2025kuhshw-design/Chess_RobotArm/docs/layout_diagram.png

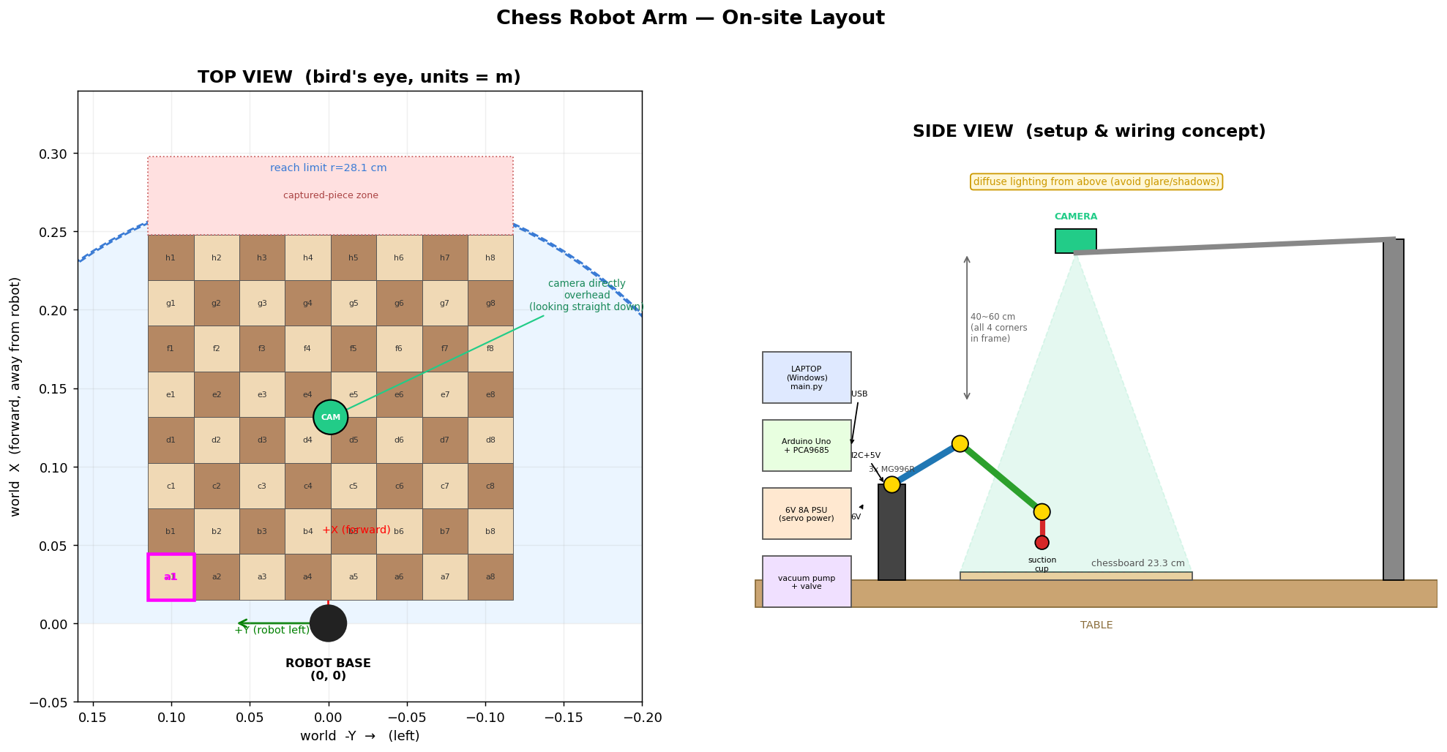
docs/layout_diagram.png
