2025kuhshw-design/Chess_RobotArm/docs/TROUBLESHOOTING_LOG.md

# 문제 해결 기록

체스 두는 로봇팔을 만들면서 실제로 막혔던 지점과 해결 방법.
**설계 단계에는 없었고, 실물을 만든 뒤에야 드러난 문제가 대부분이다.**

---

## 이 시스템이 어떻게 동작하는지 (처음 보는 사람용)

```
[카메라] 체스판을 위에서 내려다봄
   ↓  사람이 둔 수를 알아냄 (이전 사진과 지금 사진을 비교)
[체스 엔진] 다음 수를 계산
   ↓  "e7의 기물을 e5로 옮겨라"
[역기구학] 그 칸의 위치를 관절 각도로 변환
   ↓  "1번 63도, 2번 45도, 3번 160도"
[아두이노 → 서보모터] 팔을 움직이고 흡착기로 기물을 집어 옮김
```

이 네 단계 중 **어느 하나라도 어긋나면 로봇은 엉뚱한 곳을 짚는다.**
아래 문제들은 대부분 "각 단계는 맞는데 단계 사이의 약속이 틀어진" 경우다.

---

## 우선순위 한눈에 보기

`★★★` 이걸 못 고치면 프로젝트가 아예 성립 안 됨
`★★` 동작은 하지만 실패율이 높거나 부품이 망가짐
`★` 불편하지만 우회 가능

| 우선순위 | 문제 | 분야 |
|:---:|---|:---:|
| ★★★ | 어깨 높이가 코드에 없어 팔이 체스판에 닿지 못함 | SW |
| ★★★ | 팔꿈치 꺾이는 방향이 코드와 반대 | SW |
| ★★★ | 가로·세로 축이 뒤바뀌어 사람의 수를 전부 "반칙"으로 판정 | SW |
| ★★★ | 좌표가 거울처럼 뒤집혀 정반대 칸을 짚음 | SW |
| ★★★ | 흡착기가 아예 작동하지 않음 (제어 방식이 다름) | HW+SW |
| ★★★ | 펌프 전류가 모터 드라이버를 태움 | HW |
| ★★★ | 서보모터가 갑자기 튀어 기어가 파손됨 | HW+SW |
| ★★★ | 기물 32개를 전부 '빈 칸'으로 읽어 사람의 수를 감지 못함 | SW |
| ★★★ | 검은 기물이 어두운 칸에서만 안 보임 (밝기로는 구분 불가) | SW |
| ★★★ | 카메라 보정 결과를 하강 직전에 버려서 보정이 사실상 무효 | SW |
| ★★★ | 높은 데서 정렬해 시차로 한 칸 어긋남 (내려가면 틀어짐) | SW |
| ★★★ | 캐슬링·앙파상에서 엔진과 실제 판이 어긋남 | SW |
| ★★ | 기물을 집자마자 그 자리에 도로 떨어뜨림 | SW |
| ★★ | 흡착기가 기물에 안 붙음 (덜 내려감) | SW+HW |
| ★★ | 캘리브레이션 격자가 어긋나 칸이 밀림 | 사용법 |
| ★★ | 게임 도중 "도달 불가" 오류로 강제 종료 | SW |
| ★★ | 1번 관절 결합부 유격 → 위치가 매번 달라짐, 결국 서보 고장·교체 | HW |
| ★★ | 서보 교체 후 정면 기준각이 38°→85°로 바뀜 | HW+SW |
| ★★ | 칸 하나만 잘못 읽혀도 이동 감지 실패 / 잡는 수는 감지 불가 | SW |
| ★★ | 정확도를 올리려던 강화학습이 실제로는 효과 없음 | SW |
| ★ | 팔이 흔들려(3~4Hz) 집기 정확도 저하 | HW+SW |
| ★ | 로봇팔이 카메라를 가려 기물 인식이 깨짐 | SW |
| ★ | 마커(스티커) 색을 체스판으로 오인식 | SW |
| ★ | 개발 환경 설치 실패 (파이썬 버전, 라이브러리 등) | 환경 |

---

# ★★★ 치명적 — 못 고치면 프로젝트가 성립 안 됨

## 1. 어깨 높이가 코드에 없었다 (SW)

**무슨 일이 있었나**
로봇팔을 조립하고 "e5 칸으로 가"라고 시켰는데, **팔이 체스판 근처에도 못 갔다.**
어느 칸을 시켜도 "서보 각도가 범위를 벗어났다"는 오류만 났다.

**왜 그랬나**
로봇팔의 어깨 관절은 체스판보다 **8.9cm 위**에 있다. 그런데 코드는 어깨가
**체스판과 같은 높이**에 있다고 계산하고 있었다. 8.9cm 차이를 모른 채
"팔을 얼마나 굽혀야 하나"를 계산하니 답이 나올 리가 없었다.

> 비유하자면, 책상 위 물건을 집으려는데 자기 어깨가 책상 위에 있다고 착각한 것.

**어떻게 고쳤나**
`SHOULDER_HEIGHT` 값을 새로 만들어 8.9cm를 넣었다. 그러자 정상 동작.

---

## 2. 팔꿈치가 반대로 꺾인다 (SW)

**무슨 일이 있었나**
위와 같은 증상. 어깨 높이를 고쳐도 여전히 범위를 벗어났다.

**왜 그랬나**
팔이 특정 지점에 닿는 방법은 **두 가지**다 — 팔꿈치를 위로 꺾거나, 아래로 꺾거나.
(사람이 물건을 집을 때 팔꿈치를 들 수도, 내릴 수도 있는 것과 같다.)
코드는 **한 가지 방법만** 계산하고 있었는데, 우리 로봇팔은 그 반대 방향으로만
꺾이는 구조였다.

**어떻게 고쳤나**
`ELBOW_SIGN`이라는 선택 스위치를 만들어 "아래로 꺾기"를 선택했다.

> 이 두 문제(1·2)를 고치기 전까지 **로봇팔은 체스판에 닿을 수조차 없었다.**
> 코드로는 몇 줄이지만, 이게 없으면 아무리 잘 만든 AI도 소용없다.

---

## 3. 가로·세로가 뒤바뀌어 사람의 수를 전부 "반칙"으로 판정 (SW)

**무슨 일이 있었나**
사람이 정상적으로 폰을 두 칸 전진시켰는데, 프로그램이 **"불법 이동입니다"**
라며 거부했다. 어떤 수를 둬도 마찬가지였다.

**왜 그랬나**
체스판에는 두 방향이 있다.
- **랭크**(1~8): 사람 쪽에서 상대 쪽으로 가는 방향
- **파일**(a~h): 좌우 방향

코드가 이 둘을 **뒤바꿔** 놓고 있었다. 그래서 사람 앞의 두 줄이 "1·2랭크"가
아니라 "g·h파일"로 인식됐다. 체스 규칙상 백 기물은 1·2랭크에서 시작해야 하는데
엉뚱한 곳에 있으니, 엔진이 모든 수를 반칙으로 본 것이다.

**어떻게 고쳤나**
랭크가 로봇↔사람 방향이 되도록 좌표 계산식을 바로잡았다.

---

## 4. 좌표가 거울처럼 뒤집혀 있었다 (SW)

**무슨 일이 있었나**
"오른쪽 칸으로 가"라고 하면 왼쪽으로 갔다.

**왜 그랬나**
카메라가 보는 좌표를 로봇 좌표로 바꾸는 계산이 **거울상**이었다.
방향만 맞추면 될 것 같지만, 거울상은 아무리 돌려도 원래대로 안 된다.
(왼손과 오른손은 아무리 돌려도 겹쳐지지 않는 것과 같다.)

**어떻게 고쳤나**
네 가지 배치(로봇이 위/아래/왼쪽/오른쪽)를 전부 다시 계산해서,
모두 거울상이 아닌 올바른 회전이 되도록 검증했다.

---

## 5. 흡착기가 아예 작동하지 않았다 (HW+SW)

**무슨 일이 있었나**
"흡착 켜"를 아무리 보내도 펌프가 안 돌았다. 배선도 맞고 전원도 들어와 있었다.

**왜 그랬나**
펌프를 켜고 끄는 부품(스위치 모듈)이 예상과 **다른 방식**이었다.
- 예상: 전기를 계속 보내면 켜짐
- 실제: **서보모터에 보내는 것 같은 신호(짧은 펄스)**를 보내야 켜짐

**어떻게 고쳤나**
아두이노가 서보 펄스 형태로 신호를 보내도록 바꿨다.
(부품 사진을 보고 입력선이 서보와 같은 3선인 걸 확인하고서야 알았다.)

---

## 6. 펌프 전류가 모터 드라이버를 태웠다 (HW)

**무슨 일이 있었나**
흡착기를 켜자 **서보모터와 흡착기가 동시에 전부 힘이 빠졌다.** 결국 모터
드라이버가 고장 나서 교체해야 했다.

**왜 그랬나**
펌프는 켜지는 순간 **순간적으로 매우 큰 전류**(수 암페어)를 끌어당긴다.
그 전류가 **모터 드라이버 보드를 통과**하도록 배선돼 있었는데, 그 보드의
전원 배선은 서보모터용으로 가늘게 설계돼 있어 감당하지 못했다.

> 굵은 수도관(전원)이 있어도 중간에 빨대(드라이버 배선)를 끼우면 물이 안 나온다.

**어떻게 고쳤나**
펌프의 전원선을 **드라이버를 거치지 않고 외부 전원에 직접** 연결했다.
드라이버에는 "켜라/꺼라" 신호선만 남겼다.

---

## 7. 서보모터가 갑자기 튀어 기어가 파손됐다 (HW+SW)

**무슨 일이 있었나**
각도를 크게 바꾸는 명령을 넣자 **칠판 긁는 소리**가 났고, 열어보니 서보 내부
플라스틱 기어가 갈려 있었다.

**왜 그랬나**
서보모터는 목표 각도를 받으면 **자기 최대 속도로** 그리로 간다. 90도를 한 번에
움직이면 팔이 세게 휘둘러지고, 멈출 때 큰 충격이 걸린다. 게다가 팔이 구조물에
걸려 못 움직이는데도 계속 힘을 주면 기어가 갈린다.

**어떻게 고쳤나**
목표까지 **2도씩 나눠서** 여러 번 보내도록 바꿨다. (한 번에 "90도로 가"가 아니라
"2도, 4도, 6도…" 하고 순차적으로 보냄) 이러면 천천히 부드럽게 움직인다.

**추가 문제**: 전원을 켠 직후에는 팔이 어디 있는지 코드가 알 수 없어(위치 센서가
없음) 나눠 보낼 수가 없었다. → **기동 절차**를 만들어, 사람이 팔을 잡고
"지금 여기 있다"고 알려준 뒤 시작하도록 했다.

---

# ★★ 중요 — 동작은 하지만 실패하거나 망가짐

## 8. 기물을 집자마자 도로 떨어뜨렸다 (SW)

**증상**: 흡착기가 기물을 붙잡았는데, 팔을 들어올리는 순간 놓아버림.

**원인**: 팔을 움직이는 함수가 **흡착 상태를 넘겨받지 않아서**, 움직일 때마다
"흡착 꺼짐"으로 덮어쓰고 있었다.

**해결**: 집은 뒤 놓을 때까지 모든 이동 구간에 "흡착 유지"를 명시적으로 전달.
놓는 지점을 코드상 **한 곳으로만** 정리했다.

---

## 9. 흡착기가 기물에 안 붙었다 (SW+HW)

**증상**: 정확한 위치까지 내려가는데도 진공이 안 걸림.

**원인**: 흡착컵은 고무라서 **살짝 눌러야** 밀착돼 진공이 생긴다. 그런데 코드는
기물 윗면 **정확히**까지만 내려가도록 되어 있어 눌리지 않았다.

**해결**: 기물 윗면보다 **4mm 더** 내려가도록 설정(`TOUCH_PRESS`).
현장에서 `zoff 8` 같은 명령으로 실시간 조정할 수 있게 했다.

---

## 10. 캘리브레이션 격자가 어긋났다 (사용법)

**증상**: 카메라가 만든 8×8 격자가 실제 체스판 칸과 조금씩 밀려 있음.

**원인**: 카메라 설정 시 네 모서리를 찍어야 하는데, **모서리 칸의 중앙**을 찍었다.
중앙끼리의 거리는 **7칸**인데 코드는 그 범위를 **8칸**으로 나누니 전체가 밀린다.

**해결**: 8×8 영역의 **바깥 꼭짓점**을 찍도록 안내. 보드 테두리가 둥글어 찍기
어려운 경우를 위해, 중앙을 찍으면 자동으로 환산해주는 모드도 추가했다.

---

## 11. 게임 도중 "도달 불가" 오류로 강제 종료 (SW)

**두 가지 원인이 있었다.**

**(a) 들어올리는 높이가 고정이었다**
먼 칸에서는 8cm를 들어올리면 팔 길이를 초과한다.
→ 칸마다 가능한 최대 높이를 계산하도록 변경.

**(b) 잡은 기물을 놓는 위치가 팔 밖이었다**
"잡은 칸에서 옆으로 5cm" 지점에 놓게 되어 있었는데, 구석 칸에서는 그 지점이
팔이 닿는 범위 밖(30.1cm > 29.5cm)이었다.
→ 보드 바깥의 **고정된 자리**(팔이 확실히 닿는 곳)에 순서대로 놓도록 변경.

---

## 12. 1번 관절 결합부 유격 (HW) — **아직 미해결**

**증상**: 같은 명령을 줘도 **매번 조금씩 다른 위치**에 도달한다.

**원인**: 베이스 관절 결합부가 헐거워 팔이 흔들린다. 팔이 길어서 결합부의
작은 유격이 끝단에서 크게 증폭된다.

**왜 중요한가**: 유격이 있으면 **미리 계산해둔 보정값이 소용없다.** 오차가 매번
달라지기 때문이다. → 그래서 아래 13번의 접근 방식 변경이 필요했다.

**해결**: 기계적으로 조여야 한다. 소프트웨어로는 못 고친다.

**후속**: 결국 이 서보가 완전히 고장나 **회전 자체를 하지 않게 됐다.**
교체한 새 서보는 혼(horn) 결합 위치가 달라 **정면이 85°** 다(이전 서보는 38°).
`SERVO1_HOME`과 `PARK_POSE`를 그에 맞춰 고쳤다. → 아래 12-B 참고.

---

## 12-B. 베이스 서보 교체 후 정면 기준각이 바뀜 (HW+SW)

**증상**: 1번(베이스) 모터가 명령을 줘도 전혀 돌지 않음 → 서보 자체 고장.
교체 후에는 팔이 엉뚱한 방향을 향함.

**원인**: 서보에는 위치 센서가 없고, 팔(혼)을 어느 각도에 끼우느냐에 따라
"몇 도가 정면인가"가 달라진다. 교체하면 이 기준각이 바뀐다.
이전 서보는 38°가 정면, 새 서보는 실측 결과 **85°가 정면**.

**해결**: 소프트웨어에서 기준각만 바꾼다. 기구를 다시 분해할 필요는 없다.
(`a` 명령으로 몇 도일 때 정면을 향하는지 직접 재서 확인 — 아래 절차 참고.)

```python
# hardware/arm_controller.py
SERVO1_HOME = 85            # 38 → 85 (실측)
PARK_POSE   = (85, 140, 180)
```

**부수 효과(좋은 쪽)**: 예전에는 정면이 38°라 **오른쪽 회전 여유가 38°뿐**이었다.
이제 정면이 85°라 좌우 여유가 거의 같다. 실제 사용 범위는 s1 ≈ 65~137°로,
양쪽 끝(0°/180°)에서 충분히 떨어져 있다.

**교훈**: 모터를 교체하면 코드의 기준각도 반드시 다시 재야 한다.
기준각은 "모터의 성질"이 아니라 "모터와 팔을 어떻게 결합했는가"의 값이다.

---

## 12-C. 기물을 하나도 인식하지 못했다 (SW)

**증상**: 시작 배치를 놓고 실행했는데 카메라가 **32개 기물을 전부 빈 칸**으로
읽었다. 그래서 기물을 옮겨도 "이동 감지 실패"만 반복됐다.

**원인**: 기물이 있는지를 **셀 중앙의 밝기 분산**으로 판정하고 있었다.
"기물이 있으면 무늬가 생겨 분산이 커진다"는 발상이었는데, 정반대였다.
기물이 셀 중앙을 덮으면 그 부분은 오히려 **한 가지 색으로 균일**해져
분산이 0에 가까워진다.

```
빈 밝은 칸          분산 5.6     ← 나뭇결 때문에 오히려 분산이 있다
흰 기물이 덮은 칸   분산 0.0     ← 균일해서 분산이 없다
검은 기물이 덮은 칸 분산 0.0
                    임계값 200 → 셋 다 "빈 칸"으로 판정
```

**해결**: 분산이 아니라 **밝기**로 판단한다.
"이 칸이 비었을 때의 밝기"와 비교해서 밝으면 흰 기물, 어두우면 검은 기물,
비슷하면 빈 칸. 기준 밝기는 *지금 비어 있어야 할 칸들*에서 매번 새로
계산하므로 조명이 변해도 따라간다.

**교훈**: 직관("기물이 있으면 복잡해 보이겠지")을 숫자로 확인하지 않았다.
분산 값을 한 번만 찍어봤다면 바로 알 수 있었다. 그래서 지금은
`vision/check_board.py` 가 칸별 숫자를 표로 보여준다.

---

## 12-C-2. 검은 기물이 어두운 칸에서만 안 보였다 (SW)

**증상**: 밝기 방식으로 고친 뒤에도 판독이 이랬다.

```
  8 b X b X b X b X      ← 한 칸 걸러 하나씩 안 잡힘
  7 X b X b X b X b
  2 X w w w w w w w
  1 w w w w w w w X
```

칸을 격자 좌표로 바꿔 보니 **놓친 칸이 전부 같은 색(어두운 칸)** 이었다.
흰 기물은 양쪽 칸에서 다 잡혔다.

**원인**: 당연한 얘기였다. **검은 기물과 어두운 칸은 둘 다 어둡다.**
밝기 하나로는 구분할 수가 없다. 임계값을 낮추면 검은 기물이 잡히기
시작하지만, 동시에 **빈 칸의 그림자도 기물로 잡힌다**(실제로 c3에 없는
기물이 나타났다). 맞바꿈이라 임계값 조정으로는 절대 해결되지 않는다.

**해결**: 기준을 "밝기"에서 **"빈 판과 얼마나 달라졌는가"** 로 바꿨다.
기물을 다 치운 판을 한 번 찍어두고, 매번 그것과 **픽셀 단위로 비교**한다.

- 검은 기물이 어두운 칸에 있어도 나뭇결·테두리·그림자가 달라지므로 잡힌다
- 나뭇결·얼룩은 빼기에서 상쇄되므로 잡음 문턱이 훨씬 낮아진다
  (밝기 방식 18 → 픽셀 방식 12)
- **평균이 아니라 '달라진 픽셀의 비율'** 로 판단하므로 기물이 작아도 된다
- 전체 조명 변화는 빈 칸들의 중앙값으로 보정한다

합성 영상 검증 (검은 기물 밝기를 어두운 칸과 **완전히 같게** 둔 최악의 경우):

| 상황 | 밝기 방식 | 빈 판 기준 |
|---|---|---|
| 시작 배치 | 48/64 | **64/64** |
| 빈 판 (오검출) | — | **64/64** |
| 조명 +20 | — | **64/64** |
| 조명 −30 | — | **64/64** |

**교훈**: 두 대상이 같은 값을 갖는다면, 그 값으로는 영원히 구분할 수 없다.
임계값을 계속 만지는 대신 **다른 측정량**을 찾아야 했다.

---

## 12-E-2. 정렬은 맞았다는데 내려가면 한 칸 어긋났다 (SW)

**증상**: 칸 위에서 정렬이 "완료"라고 뜨고 화면상으로도 맞아 보이는데,
하강하는 순간 한 칸 가까이 어긋났다. 흡착컵이 실제로는 e7 바로 위에 있는데
카메라 화면에는 마커가 e8 에 찍히기도 했다.

**원인**: **시차(parallax)**. 카메라가 판을 정확히 수직으로 내려다보지
않으면, 판 **위로 떠 있는** 마커는 판 평면에 투영될 때 밀려 보인다.
그리고 이 밀림은 **높이에 비례**한다.

```
밀림 = h/(H-h) x (판 중심에서의 거리)      h=마커 높이, H=카메라 높이
```

정렬은 안전높이(4.5cm)에서 했는데 실제 작업은 바닥(0.15cm)에서 한다.
높이가 다르니 밀림도 다르다. 즉 **높은 데서 "맞다"고 판단한 위치가
낮은 데서는 틀린 위치**였다.

| 정렬 높이 | 흡착컵 실제 오차 |
|---|---|
| 4.5cm (예전) | 19.0mm = 0.65칸 |
| 1.65cm | 6.5mm |
| **0.65cm (지금)** | **2.5mm** |

**해결**: **실제로 일할 높이에서 잰다.**

1. 기물 윗면 2mm 위까지 내려가서 측정
2. 보정이 필요하면 12mm 로 잠깐 올라가 옆으로 옮기고 다시 내려와 재측정
   (측정 높이에서 바로 옆으로 가면 옆 칸 기물을 밀어버린다)
3. 허용치 안에 들면 **그 자리에서 순수 수직으로만** 하강

핵심은 3번이다. 마지막 하강이 수직이면 그 사이 마커가 어떻게 보이든
**흡착컵의 실제 xy 는 변하지 않는다.** 그래서 남는 오차는 '정렬한 높이에서의
시차' 그 자체이고, 그 높이를 낮춘 만큼 그대로 줄어든다(4.5cm→0.65cm = 8배).

**교훈**: 센서를 **쓸 조건과 같은 조건에서** 재야 한다. 편한 높이에서 재고
다른 높이에서 쓰면, 측정이 아무리 정확해도 그 차이만큼 그대로 틀린다.

---

## 12-D. 이동 감지가 조금만 어긋나도 실패했다 (SW)

**증상**: 인식이 되더라도 이동을 자주 못 읽었다. 특히 **기물을 잡는 수**는
한 번도 못 읽었다.

**원인**: "이전 배치와 비교해 **사라진 칸 1개 + 나타난 칸 1개**"를 찾는
차분(diff) 방식이었다.
- 칸 하나만 잘못 읽혀도 개수가 안 맞아 실패한다.
- 잡는 수는 도착칸이 원래 차 있어서 "나타난 칸"이 0개다 → 원리적으로 불가능.

**해결**: **우리는 체스 규칙을 이미 알고 있다**는 점을 쓰지 않고 있었다.
지금 국면의 합법수는 보통 20~40개뿐이다. 각 수를 뒀을 때 판이 어떻게 보일지
미리 만들어두고, **화면과 가장 잘 맞는 것**을 고른다.

모의실험 200판 (칸을 무작위로 오독시켰을 때 정답률):

| 잘못 읽은 칸 | 기존 차분 | 합법수 대조 |
|---|---|---|
| 0칸 | 98% | 100% |
| 1칸 | 44% | 98% |
| 2칸 | 27% | 91% |
| 3칸 | — | 88% |

1등과 2등이 비슷하면 후보 5개를 보여주고 사람이 고른다 → 게임이 멈추지 않는다.

**교훈**: 센서를 더 정확하게 만들려 애쓰기 전에, **이미 가진 정보(규칙)를
쓰고 있는지** 먼저 확인하자. 인식 성능을 그대로 두고도 정답률이 44%→98%가 됐다.

---

## 12-E. 카메라 보정이 하강 직전에 지워졌다 (SW)

**증상**: 카메라 정렬을 넣었는데도 집기 정확도가 나아지지 않았다.
로그에는 "정렬 완료"가 찍히는데 결과가 그대로였다.

**원인**: 정렬 함수가 팔을 보정된 위치로 옮겨놓고 **성공/실패(True/False)만**
돌려줬다. 그런데 그 다음 하강 단계가 **목표 칸 좌표로 역기구학을 다시 계산**했다.
즉 보정으로 옮겨둔 위치가 하강 직전에 **원위치로 되돌아갔다.**

```
1. e5 칸 위로 이동          → (4.00, 4.00)
2. 카메라로 보정            → (3.60, 4.24)   ← 맞춰짐
3. 하강하려고 IK 재계산      → (4.00, 4.00)   ← 보정이 사라짐 ✗
```

가장 중요한 순간(하강·흡착)에만 보정이 빠져 있었으니, 정렬은 돌지만
결과에는 아무 영향이 없었다.

**해결**: 정렬 함수가 **보정량(칸 단위)** 을 돌려주고, 이후 하강·흡착·상승이
전부 그 값을 얹어 계산하도록 바꿨다.

가짜 하드웨어로 검증 (팔이 항상 +0.5칸, −0.3칸 어긋나 도착한다고 가정):

| | 하강 지점 오차 |
|---|---|
| 고치기 전 | 17.0 mm (보정이 사라져 원래대로) |
| 고친 뒤 | **3.4 mm** |

**같이 고친 것**: 흡착을 켜고 끄는 단계도 `inverse_kinematics(touch_xyz(...))`를
다시 불러 보정을 날리고 있었다. 흡착 직전에 팔이 보정량만큼 튀는 원인이었다.
"자세는 그대로 두고 흡착 비트만 바꾸는" 호출로 바꿨다.

**교훈**: 되먹임(feedback)은 **측정 → 보정 → 그 보정을 유지**까지 가야 한다.
앞의 둘만 있고 마지막이 빠지면 로그상으로는 완벽하게 동작하는 것처럼 보인다.

---

## 12-F. 강화학습 보정을 엉뚱한 위치에 적용했다 (SW)

**증상**: 겉으로는 정상. 하지만 보정이 이론대로 듣지 않는다.

**원인**: 보정값을 **출발 칸 하나로 한 번만** 계산해서, 도착 칸·상승 지점까지
**전부 같은 값**을 썼다. 보정량은 팔 자세에 따라 달라지는 값이라 이건 틀렸다.

**해결**: 값 대신 **함수**를 넘겨, 이동하는 목표마다 새로 계산하게 했다.
한 수를 두는 동안 4개의 서로 다른 목표에 각각 보정이 계산된다.

---

## 12-G. 캐슬링·앙파상이면 판이 통째로 어긋난다 (SW)

**증상**: 평소엔 잘 되다가 캐슬링이나 앙파상이 나오면 그 뒤로 엔진이 아는
판과 실제 판이 달라져 게임이 망가진다.

**원인**: `execute_move` 가 **"한 수 = 기물 하나를 from→to"** 라고 가정했다.
규칙상 한 수라도 물리적으로는 동작이 여러 개인 경우가 있다.

| 수 | 규칙상 | 로봇이 하던 일 |
|---|---|---|
| 캐슬링 | 킹 + 룩 둘 다 이동 | 킹만 옮기고 **룩이 그대로 남음** |
| 앙파상 | 옆 칸 폰이 잡힘 | 도착 칸(빈 칸)을 치우려 하고 **잡힐 폰은 남음** |
| 승진 | 폰 → 퀸 | 판엔 폰인데 엔진은 퀸으로 앎 |

**해결**: 수를 **물리 동작 목록으로 분해**하는 함수를 만들었다
(`utils/chess_utils.physical_ops`).

```
캐슬링 e8g8 → [옮기기 e8→g8, 옮기기 h8→f8]
앙파상 e5d6 → [치우기 d5, 옮기기 e5→d6]
일반 잡기    → [치우기 도착칸, 옮기기]
```

승진은 로봇이 기물을 바꿔 끼울 수 없으므로 **사람에게 안내**한다.

**교훈**: "규칙상 한 수"와 "물리적으로 한 동작"은 다르다. 규칙을 쓰는
소프트웨어와 물리를 다루는 하드웨어 사이에는 항상 이런 번역 계층이 필요하다.

---

## 12-H. 라그랑주 관성 계산에서 베이스 축만 틀렸다 (SW)

**증상**: 겉으로는 정상. 토크 경고가 실제보다 크게 나온다.

**원인**: 베이스(1번 관절)는 **연직축** 회전이라 관성이 '수평 투영 거리'의
제곱으로 정해진다. 그런데 코드는 팔 평면 안의 거리를 그대로 쓰고 있었다.
팔을 세울수록 수평 거리는 짧아지는데 그 효과가 빠져 있었다.

| 자세 | 예전 | 수정 | 과대평가 |
|---|---|---|---|
| a8 (팔 세움, q2=65°) | 0.00447 | 0.00253 | **77%** |
| e5 (q2=41°) | 0.00836 | 0.00734 | 14% |
| h4 (팔 폄, q2=11°) | 0.01235 | 0.01226 | 1% |

`q2` 변수를 꺼내놓고 식에서 한 번도 안 쓴 게 단서였다(정적 검사에서 발견).

**해결**: 수평 투영 거리로 다시 유도했다.
어깨·팔꿈치(M22·M23·M33)와 중력항(G)은 원래 맞았다 — 그쪽은 평면 내
거리가 맞는 값이기 때문이다.

---

## 13. 강화학습 보정이 실제로는 효과가 없었다 (SW)

**기대했던 것**: 시뮬레이터에서 강화학습으로 오차 보정을 학습시켜 정확도를 올린다.

**실제로 알게 된 것**
시뮬레이터에서 학습한 보정은 **"수식과 시뮬레이터의 차이"**를 배운 것이지,
**우리 로봇의 실제 오차**를 배운 게 아니다. 실물을 한 번도 본 적 없는 AI가
실물의 오차를 줄일 수는 없다.

**게다가** 기구학을 수정(문제 1·2)하자 학습해둔 모델을 쓸 수 없게 됐다.
관절 각도 범위가 학습 당시와 **하나도 겹치지 않아서**(팔꿈치는 부호까지 반대),
모델 입장에서는 한 번도 본 적 없는 상황이 되었기 때문이다.

**어떻게 해결했나 — 접근 방식을 세 번 바꿨다**

| 시도 | 방법 | 결과 |
|---|---|---|
| ① | 시뮬레이터에서 강화학습 | ❌ 실제 오차와 무관 |
| ② | 실제로 오차를 자로 재서 보정식 만들기 | ⭕ 계통 오차는 잡힘. 단 **유격 때문에 한계** |
| ③ | **카메라로 보고 틀린 만큼 다시 움직이기** | ✅ 유격이 있어도 대응 |

③번이 최종 해법이다. 흡착기에 색 스티커를 붙이고, 카메라로 "지금 실제로 어디
있는지" 본 뒤 **목표와의 차이만큼 다시 움직인다.** 오차가 허용치 안에 들어올
때까지 반복한다. (시뮬 검증: 17mm 오차 → 2회 반복에 3mm)

> **가장 큰 배움**: 정확도를 실제로 올린 것은 화려한 AI 기법이 아니라,
> **실제로 재고 되먹이는 것**이었다.

---

# ★ 개선 — 불편하지만 우회 가능

## 14. 팔이 흔들려 정확도 저하 (HW+SW)
영상을 프레임 단위로 분석하니 **3~4Hz의 구조 진동**이 있었다(서보 지터가 아니라
팔 구조물이 휘어 생기는 흔들림). 이동을 멈춰도 몇 번 더 출렁인다.
→ 하강·흡착 직전에 **0.4초 대기**해서 진동이 잦아든 뒤 동작하도록 했다.

## 15. 로봇팔이 카메라를 가림 (SW)
로봇이 움직이는 동안에는 팔이 체스판을 가려 기물 인식이 깨진다.
→ 원래 보드를 읽는 건 사람이 수를 둔 뒤뿐이라 문제없지만, 확실히 하기 위해
**보드를 읽기 직전에 팔을 대기 자세로 물리도록** 했다. 또 **연속 두 번 같게
읽힐 때만** 결과를 채택하도록 해서 손이 지나가는 순간을 걸러낸다.

## 16. 마커 색을 체스판으로 오인식 (SW)
흡착기 위치를 알려주는 노란 스티커가 **체스판 나무색과 색상이 비슷**해서
보드를 마커로 착각했다.
→ **채도**(색의 진하기)로 구분. 나무색은 채도가 낮고 형광 노랑은 높다.
또 검출된 덩어리가 한 칸의 절반보다 크면 "보드를 잘못 잡은 것"으로 보고 무시.

## 17. 개발 환경 설치 실패 (환경)

| 증상 | 원인·해결 |
|---|---|
| `No module named 'serial'` | 설치는 `pyserial`, 불러오기는 `serial` (이름이 다름) |
| 포트 접근 거부 | 아두이노 IDE의 시리얼 모니터가 포트를 잡고 있음 → 닫기 |
| 라이브러리 설치가 통째로 실패 | **파이썬 3.14 사용** — 최신 버전은 미리 만들어진 설치 파일이 없어 직접 컴파일을 시도하다 실패 → 3.11/3.12 사용 |
| pip이 한글 오류 | 설정 파일의 한글 주석을 윈도우가 못 읽음 → 영문으로 변경 |
| 시뮬레이터(pybullet) 설치 불가 | **윈도우용 설치 파일이 아예 없음** → 구글 코랩에서 실행 |
| 파일이 차단됨 | 윈도우 보안 기능이 서명 없는 파일을 차단 → 코랩 사용 |

---

# 재발 방지 장치

같은 문제를 또 겪지 않도록 코드에 넣은 것들.

| 장치 | 막아주는 문제 |
|---|---|
| **펌웨어 버전 확인** | 아두이노에 새 코드 업로드를 깜빡하는 것 (연결 시 자동 경고) |
| **각도 안전 제한** | 팔이 구조물에 처박히는 것 |
| **범위 초과 시 명시적 오류** | 못 가는 칸인데 경고 없이 엉뚱한 곳으로 가는 것 |
| **기동 절차** | 전원 켠 직후 팔이 갑자기 튀는 것 |
| **정착 대기** | 흔들리는 중에 집으려다 실패하는 것 |
| **하강 전 확인** | 잘못된 위치로 내려가 기물을 쓰러뜨리는 것 |
| **도달 지도 (`check`)** | 어느 칸이 닿는지 몰라 헤매는 것 |

---

# 아직 남은 것

1. **1번 관절 결합부 유격** — 기계적으로 조여야 함 (진동의 주원인)
2. **강화학습 재학습** — 코랩에서 진행 중 (현재 10만 스텝, 권장 최소 30만)
3. **전체 게임 실전 테스트** — 개별 동작은 확인, 끝까지 한 판은 미완
