2025kuhshw-design/Chess_RobotArm/setup/urdf/robot_simple.urdf

<?xml version="1.0"?>
<robot name="chess_arm">
  <link name="base_link">
    <visual>
      <geometry>
        <cylinder radius="0.0120" length="0.1400"/>
      </geometry>
      <origin xyz="0 0 0.0700" rpy="0 0 0"/>
      <material name="color_base_link">
        <color rgba="0.25 0.25 0.30 1.00"/>
      </material>
    </visual>
    <collision>
      <geometry>
        <cylinder radius="0.0120" length="0.1400"/>
      </geometry>
      <origin xyz="0 0 0.0700" rpy="0 0 0"/>
    </collision>
    <inertial>
      <mass value="0.12"/>
      <origin xyz="0 0 0.0700" rpy="0 0 0"/>
      <inertia ixx="0.000200" ixy="0" ixz="0" iyy="0.000200" iyz="0" izz="0.000009"/>
    </inertial>
  </link>
  <link name="base_link_joint_sphere">
    <visual>
      <geometry>
        <sphere radius="0.0180"/>
      </geometry>
      <origin xyz="0 0 0" rpy="0 0 0"/>
      <material name="joint_color">
        <color rgba="0.95 0.80 0.10 1.0"/>
      </material>
    </visual>
    <inertial>
      <mass value="0.001"/>
      <origin xyz="0 0 0" rpy="0 0 0"/>
      <inertia ixx="1e-7" ixy="0" ixz="0" iyy="1e-7" iyz="0" izz="1e-7"/>
    </inertial>
  </link>
  <joint name="sphere_joint_base_link" type="fixed">
    <parent link="base_link"/>
    <child link="base_link_joint_sphere"/>
    <origin xyz="0 0 0" rpy="0 0 0"/>
  </joint>
  <link name="link1">
    <visual>
      <geometry>
        <cylinder radius="0.0120" length="0.1550"/>
      </geometry>
      <origin xyz="0 0 0.0775" rpy="0 0 0"/>
      <material name="color_link1">
        <color rgba="0.18 0.52 0.80 1.00"/>
      </material>
    </visual>
    <collision>
      <geometry>
        <cylinder radius="0.0120" length="0.1550"/>
      </geometry>
      <origin xyz="0 0 0.0775" rpy="0 0 0"/>
    </collision>
    <inertial>
      <mass value="0.08"/>
      <origin xyz="0 0 0.0775" rpy="0 0 0"/>
      <inertia ixx="0.000163" ixy="0" ixz="0" iyy="0.000163" iyz="0" izz="0.000006"/>
    </inertial>
  </link>
  <link name="link1_joint_sphere">
    <visual>
      <geometry>
        <sphere radius="0.0180"/>
      </geometry>
      <origin xyz="0 0 0" rpy="0 0 0"/>
      <material name="joint_color">
        <color rgba="0.95 0.80 0.10 1.0"/>
      </material>
    </visual>
    <inertial>
      <mass value="0.001"/>
      <origin xyz="0 0 0" rpy="0 0 0"/>
      <inertia ixx="1e-7" ixy="0" ixz="0" iyy="1e-7" iyz="0" izz="1e-7"/>
    </inertial>
  </link>
  <joint name="sphere_joint_link1" type="fixed">
    <parent link="link1"/>
    <child link="link1_joint_sphere"/>
    <origin xyz="0 0 0" rpy="0 0 0"/>
  </joint>
  <link name="link2">
    <visual>
      <geometry>
        <cylinder radius="0.0120" length="0.0750"/>
      </geometry>
      <origin xyz="0 0 0.0375" rpy="0 0 0"/>
      <material name="color_link2">
        <color rgba="0.20 0.70 0.40 1.00"/>
      </material>
    </visual>
    <collision>
      <geometry>
        <cylinder radius="0.0120" length="0.0750"/>
      </geometry>
      <origin xyz="0 0 0.0375" rpy="0 0 0"/>
    </collision>
    <inertial>
      <mass value="0.04"/>
      <origin xyz="0 0 0.0375" rpy="0 0 0"/>
      <inertia ixx="0.000020" ixy="0" ixz="0" iyy="0.000020" iyz="0" izz="0.000003"/>
    </inertial>
  </link>
  <link name="link2_joint_sphere">
    <visual>
      <geometry>
        <sphere radius="0.0180"/>
      </geometry>
      <origin xyz="0 0 0" rpy="0 0 0"/>
      <material name="joint_color">
        <color rgba="0.95 0.80 0.10 1.0"/>
      </material>
    </visual>
    <inertial>
      <mass value="0.001"/>
      <origin xyz="0 0 0" rpy="0 0 0"/>
      <inertia ixx="1e-7" ixy="0" ixz="0" iyy="1e-7" iyz="0" izz="1e-7"/>
    </inertial>
  </link>
  <joint name="sphere_joint_link2" type="fixed">
    <parent link="link2"/>
    <child link="link2_joint_sphere"/>
    <origin xyz="0 0 0" rpy="0 0 0"/>
  </joint>
  <link name="end_effector">
    <visual>
      <geometry>
        <cylinder radius="0.0120" length="0.0300"/>
      </geometry>
      <origin xyz="0 0 0.0150" rpy="0 0 0"/>
      <material name="color_end_effector">
        <color rgba="0.90 0.40 0.15 1.00"/>
      </material>
    </visual>
    <collision>
      <geometry>
        <cylinder radius="0.0120" length="0.0300"/>
      </geometry>
      <origin xyz="0 0 0.0150" rpy="0 0 0"/>
    </collision>
    <inertial>
      <mass value="0.03"/>
      <origin xyz="0 0 0.0150" rpy="0 0 0"/>
      <inertia ixx="0.000003" ixy="0" ixz="0" iyy="0.000003" iyz="0" izz="0.000002"/>
    </inertial>
  </link>
  <link name="end_effector_joint_sphere">
    <visual>
      <geometry>
        <sphere radius="0.0180"/>
      </geometry>
      <origin xyz="0 0 0" rpy="0 0 0"/>
      <material name="joint_color">
        <color rgba="0.95 0.80 0.10 1.0"/>
      </material>
    </visual>
    <inertial>
      <mass value="0.001"/>
      <origin xyz="0 0 0" rpy="0 0 0"/>
      <inertia ixx="1e-7" ixy="0" ixz="0" iyy="1e-7" iyz="0" izz="1e-7"/>
    </inertial>
  </link>
  <joint name="sphere_joint_end_effector" type="fixed">
    <parent link="end_effector"/>
    <child link="end_effector_joint_sphere"/>
    <origin xyz="0 0 0" rpy="0 0 0"/>
  </joint>
  <joint name="joint1" type="revolute">
    <parent link="base_link"/>
    <child link="link1"/>
    <origin xyz="0 0 0.1400" rpy="0 0 0"/>
    <axis xyz="0 0 1"/>
      <limit lower="-3.14" upper="3.14" effort="1.27" velocity="6.0"/>
  </joint>
  <joint name="joint2" type="revolute">
    <parent link="link1"/>
    <child link="link2"/>
    <origin xyz="0 0 0.1550" rpy="0 0 0"/>
    <axis xyz="0 1 0"/>
      <limit lower="-1.2" upper="1.2" effort="1.27" velocity="6.0"/>
  </joint>
  <joint name="joint3" type="revolute">
    <parent link="link2"/>
    <child link="end_effector"/>
    <origin xyz="0 0 0.0750" rpy="0 0 0"/>
    <axis xyz="0 1 0"/>
      <limit lower="-1.5" upper="1.5" effort="1.27" velocity="6.0"/>
  </joint>
</robot>
