2025kuhshw-design/Chess_RobotArm/hardware/arduino/servo_control.ino

/*
 * 체스 로봇팔 아두이노 제어 (PCA9685 16채널 PWM 드라이버 사용)
 *
 * 하드웨어 구성:
 *   - Arduino Uno (로직/시리얼만 담당, USB 전원)
 *   - PCA9685 서보 드라이버 (I2C: SDA=A4, SCL=A5, VCC=Uno 5V)
 *   - 외부 6V 8A 어댑터 → PCA9685 V+ 터미널 (서보/펌프/밸브 구동 전원)
 *   - 공통 GND: 외부전원 GND ─ PCA GND ─ Uno GND 모두 연결
 *
 * PCA9685 채널 배치:
 *   ch0 = joint1 서보 (베이스, MG996R)
 *   ch1 = joint2 서보 (어깨,   MG996R)
 *   ch2 = joint3 서보 (팔꿈치, MG996R)
 *   ch4 = 펌프   (인라인 PWM MOSFET 보드)
 *   ch5 = 밸브   (인라인 PWM MOSFET 보드)
 *
 * 시리얼 명령(기존과 동일): "A{각도1},{각도2},{각도3},{흡착기}\n"
 *   예: "A120,85,60,1\n"  (흡착기 1=집기 / 0=놓기)
 * 응답: "OK\n" 또는 "ERR\n"
 *
 * ※ Adafruit PWM Servo Driver Library 설치 필요
 *   (Arduino IDE → 라이브러리 매니저 → "Adafruit PWM Servo Driver" 검색)
 */

#include <Wire.h>
#include <Adafruit_PWMServoDriver.h>

// ─────────────────────────────────────────
// PCA9685 채널 / 상수
// ─────────────────────────────────────────
#define CH_JOINT1   0
#define CH_JOINT2   1
#define CH_JOINT3   2
#define CH_PUMP     4
#define CH_VALVE    5

// 펌웨어 버전 — 파이썬 쪽(arm_controller.EXPECTED_FW)과 일치해야 한다.
// .ino를 고칠 때마다 올릴 것. 재업로드를 잊으면 파이썬이 경고해 준다.
#define FW_VERSION "3"

#define BAUD_RATE     9600
#define ANGLE_MIN     0
#define ANGLE_MAX     180
// 확장 최대각: 180을 넘겨 더 꺾어야 할 때만. ⚠️ 서보 하드 스톱에 부딪히면
// 스톨→기어 손상. 반드시 조금씩 올리며 긁는 소리 나면 즉시 멈출 것.
#define ANGLE_HARD_MAX 200
#define NEUTRAL_ANGLE 90
#define TIMEOUT_MS    5000   // 5초 이상 명령 없으면 중립 복귀

// 서보 PWM 펄스 범위 (PCA9685 12비트 카운트, 50Hz 기준)
// 50Hz → 주기 20ms → 4096카운트. 1ms≈205, 2ms≈410.
// MG996R 실측에 맞춰 SERVO_MIN/MAX를 미세 조정하세요(과구동 시 서보 떨림/발열).
#define SERVO_FREQ    50
#define SERVO_MIN_PWM 110   // 약 0.54ms (0도)
#define SERVO_MAX_PWM 510   // 약 2.49ms (180도)
#define SERVO_PWM_CEIL 560  // 절대 펄스 상한 (과구동 방지, ~2.73ms)

// 펌프/밸브 스위치 모듈(FZ006류)은 서보 3선(신호/V+/GND)으로 연결되며,
// 상시 HIGH가 아니라 "서보 펄스(펄스폭)"로 켜고 끈다.
//   ON  = 한쪽 끝 펄스(약 2.4ms),  OFF = 반대쪽 끝 펄스(약 0.5ms)
// 모듈이 반대로 동작하면 DEV_ON_PULSE / DEV_OFF_PULSE 값을 서로 바꾸면 된다.
#define DEV_ON_PULSE   SERVO_MAX_PWM   // 510 ≈ 2.4ms → 모듈 ON
#define DEV_OFF_PULSE  SERVO_MIN_PWM   // 110 ≈ 0.5ms → 모듈 OFF

// 밸브 동작 정의 (밸브 종류에 맞게 조정)
//   → 집기(흡착ON): 펌프 ON, 밸브 OFF(닫힘=진공 유지)
//   → 놓기(흡착OFF): 펌프 OFF, 밸브 ON(열림=진공 해제, 기물 낙하)
//   밸브가 반대로 동작하면 VALVE_HOLD/RELEASE 값을 서로 바꾼다.
#define VALVE_HOLD    DEV_OFF_PULSE  // 집기 중 밸브 상태(진공 유지)
#define VALVE_RELEASE DEV_ON_PULSE   // 놓기 시 밸브 상태(진공 해제)

// ─────────────────────────────────────────
// 전역 변수
// ─────────────────────────────────────────
Adafruit_PWMServoDriver pwm = Adafruit_PWMServoDriver();   // 기본 주소 0x40
unsigned long lastCmdTime = 0;
String inputBuffer = "";

// ─────────────────────────────────────────
// 각도(0~180) → PCA9685 PWM 카운트
// ─────────────────────────────────────────
int angleToPulse(int angle) {
  if (angle < ANGLE_MIN) angle = ANGLE_MIN;
  if (angle > ANGLE_HARD_MAX) angle = ANGLE_HARD_MAX;
  // 0~180을 SERVO_MIN~MAX로 고정 스케일, 180 초과는 같은 기울기로 외삽.
  long p = SERVO_MIN_PWM + (long)angle * (SERVO_MAX_PWM - SERVO_MIN_PWM) / 180;
  if (p > SERVO_PWM_CEIL) p = SERVO_PWM_CEIL;   // 과구동 방지 상한
  return (int)p;
}

// ─────────────────────────────────────────
// setup
// ─────────────────────────────────────────
void setup() {
  Serial.begin(BAUD_RATE);

  Wire.begin();
  pwm.begin();
  pwm.setOscillatorFrequency(27000000);   // 내부 오실레이터(라이브러리 권장값)
  pwm.setPWMFreq(SERVO_FREQ);             // 서보용 50Hz

  // ⚠️ 부팅 시 서보를 중립(90도)으로 보내지 않는다.
  // 전원을 끈 채 팔을 손으로 옮겨두면 실제 위치와 90도의 차이만큼
  // 전속력으로 튀어(슬램) 기어가 손상된다. 서보 출력을 끈 상태(무부하)로
  // 두고, 첫 A 명령이 올 때부터 제어를 시작한다.
  // 펌프/밸브만 확실히 OFF.
  pwm.setPWM(CH_PUMP,  0, DEV_OFF_PULSE);
  pwm.setPWM(CH_VALVE, 0, DEV_OFF_PULSE);
  pwm.setPWM(CH_JOINT1, 0, 0);   // 출력 off → 서보 무부하(힘 안 걸림)
  pwm.setPWM(CH_JOINT2, 0, 0);
  pwm.setPWM(CH_JOINT3, 0, 0);
  lastCmdTime = millis();

  Serial.print("READY fw=");
  Serial.println(FW_VERSION);
}

// ─────────────────────────────────────────
// loop
// ─────────────────────────────────────────
void loop() {
  // 시리얼 수신
  while (Serial.available() > 0) {
    char c = (char)Serial.read();
    if (c == '\n') {
      processCommand(inputBuffer);
      inputBuffer = "";
    } else {
      inputBuffer += c;
    }
  }

  // (타임아웃 자동 중립복귀 제거 — 마지막 명령 위치를 그대로 유지)
}

// ─────────────────────────────────────────
// 명령 파싱 및 실행
// ─────────────────────────────────────────
void processCommand(String cmd) {
  cmd.trim();

  // 명령 형식 검증: "A{a1},{a2},{a3},{suction}"
  if (cmd.length() < 2 || cmd.charAt(0) != 'A') {
    Serial.println("ERR");
    return;
  }

  String body = cmd.substring(1);   // "A" 제거
  int v[4];
  int idx = 0;
  int start = 0;

  for (int i = 0; i <= body.length() && idx < 4; i++) {
    if (i == body.length() || body.charAt(i) == ',') {
      v[idx++] = body.substring(start, i).toInt();
      start = i + 1;
    }
  }

  if (idx < 4) {
    Serial.println("ERR");
    return;
  }

  int a1      = v[0];
  int a2      = v[1];
  int a3      = v[2];
  int suction = v[3];

  // 각도 유효 범위 검증 (확장 최대각까지 허용)
  if (a1 < ANGLE_MIN || a1 > ANGLE_HARD_MAX ||
      a2 < ANGLE_MIN || a2 > ANGLE_HARD_MAX ||
      a3 < ANGLE_MIN || a3 > ANGLE_HARD_MAX ||
      suction < 0 || suction > 1) {
    Serial.println("ERR");
    return;
  }

  // 서보 이동 (PCA9685 채널 PWM)
  pwm.setPWM(CH_JOINT1, 0, angleToPulse(a1));
  pwm.setPWM(CH_JOINT2, 0, angleToPulse(a2));
  pwm.setPWM(CH_JOINT3, 0, angleToPulse(a3));

  // 흡착기: 비트 1개 → 펌프 + 밸브 두 채널로 (서보 펄스로 스위칭)
  if (suction == 1) {
    pwm.setPWM(CH_PUMP,  0, DEV_ON_PULSE);  // 펌프 ON (진공 생성)
    pwm.setPWM(CH_VALVE, 0, VALVE_HOLD);    // 밸브 닫힘 (진공 유지)
  } else {
    pwm.setPWM(CH_PUMP,  0, DEV_OFF_PULSE); // 펌프 OFF
    pwm.setPWM(CH_VALVE, 0, VALVE_RELEASE); // 밸브 열림 (진공 해제 → 기물 낙하)
  }

  lastCmdTime = millis();
  Serial.println("OK");
}

// ─────────────────────────────────────────
// 중립 위치로 복귀 (서보 90도, 펌프/밸브 OFF)
// ─────────────────────────────────────────
void goNeutral() {
  pwm.setPWM(CH_JOINT1, 0, angleToPulse(NEUTRAL_ANGLE));
  pwm.setPWM(CH_JOINT2, 0, angleToPulse(NEUTRAL_ANGLE));
  pwm.setPWM(CH_JOINT3, 0, angleToPulse(NEUTRAL_ANGLE));
  pwm.setPWM(CH_PUMP,  0, DEV_OFF_PULSE);
  pwm.setPWM(CH_VALVE, 0, DEV_OFF_PULSE);   // 중립: 펌프/밸브 OFF
}
