2025kuhshw-design/Chess_RobotArm/(commit log)

2026-05-04 feat: 체스 로봇팔 전체 파이프라인 초기 구현 (PHASE 0~5)
    - PHASE 0: requirements.txt, setup/stl_to_urdf.py, URDF 자동 생성
    - PHASE 1: utils/ik_solver.py (역기구학/순기구학/좌표변환)
    utils/lagrange.py (토크 계산/한계 검증)
    utils/chess_utils.py (Stockfish 연동/이동 변환)
    - PHASE 2: sim/env_simple.py (1단계 PyBullet RL 환경)
    sim/env_full.py (2단계 Domain Randomization 확장)
    sim/train_correction.py (PPO 학습, Colab 체크포인트 지원)
    - PHASE 3: vision/calibrate.py (마우스 클릭 캘리브레이션)
    vision/detect.py (기물 인식, 이동 감지)
    - PHASE 4: hardware/arduino/servo_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
    [robot_full.urdf, robot_simple.urdf]
2026-05-04 feat: 라그랑주 토크를 RL observation에 추가 (9차원 → 12차원)
    - env_simple.py: tau1, tau2, tau3 (라그랑주 필요 토크) observation 추가
    - 토크 한계 초과 시 초과 비율 비례 페널티 적용 (더 정교한 보상)
    - main.py, test_pipeline.py: 12차원 observation에 맞게 업데이트
    RL이 토크 정보를 보고 서보 한계를 고려한 보정값 학습 가능
    https://claude.ai/code/session_01LH4EnHTZqRnCXBSVhiNqwi
2026-05-04 tune: 1단계 학습 스텝 500k → 1.5M (12차원 observation 반영)
    라그랑주 토크 추가로 observation 차원 증가,
    충분한 학습을 위해 스텝 수 3배 확대
    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
2026-05-04 tune: 보상 함수 개선 + 1단계 스텝 2M으로 확대
    - 중간 보상 추가 (10cm→+10, 5cm→+30) sparse reward 문제 해결
    - 거리 페널티 강화 (-dist×10 → -dist×20)
    - 이전 스텝 대비 가까워지면 +5 (방향 학습 유도)
    - 1단계 학습 스텝 1.5M → 2M
    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
2026-05-04 fix: 실측 치수 반영 및 체스판 위치 재조정
    실측 팔 길이: L1=140mm, L2=155mm, L3=75mm (기존 설계값과 다름)
    - utils/ik_solver.py, lagrange.py, sim/env_simple.py L1/L2/L3 수정
    - 체스판 위치 재조정: 원점(0.015, -0.115) — 전 칸 도달 가능(최대 263mm < 283mm)
    - setup/stl_to_urdf.py 실측 관절 좌표 반영
    - test_pipeline.py 테스트 좌표 실측 팔 범위로 수정
    - URDF 재생성
    테스트: ik ✅ lagrange ✅ full ✅ (토크 전부 한계 이내)
    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
    [robot_full.urdf, robot_simple.urdf]
2026-05-04 refactor: joint1을 원점으로 단순화, 불필요한 베이스 오프셋 제거
    역기구학은 joint1 축 기준으로 계산하므로
    절대 좌표(32,63,6)mm 불필요 → L1/L2/L3만 사용
    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
2026-05-05 fix: 체스판 칸 크기 실측값 반영 (2.8cm → 2.9125cm)
    23.3cm × 23.3cm 실제 체스판 기준
    23.3 ÷ 8 = 2.9125cm per 칸
    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
2026-05-05 fix: Serena MCP --project-root → --project 플래그 수정
    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
2026-05-05 fix: RL 환경 버그 수정 및 학습 안정화
    - REACH_FINE 0.005→0.010m (1cm): 0.5cm 기준 너무 빡빡해 수렴 불안정
    - _simulate_real_joints: 고정 노이즈→self._noise_scale 사용 (DR 미적용 버그 수정)
    - env_full: _set_dr_params() 오버라이드로 DR 파라미터가 초기 상태 계산 전에 적용
    - 모듈 레벨 임포트: step()마다 반복되던 lagrange/ik_solver 임포트 제거
    - MetricsCallback: 성공 기준 하드코딩 2cm→REACH_FINE 동기화
    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
2026-05-05 fix: STAGE1_STEPS 2M→3M (기존 체크포인트에서 1M 추가 학습)
    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
2026-05-07 feat: RL 학습 전면 개선 (과적합 방지 + 필수 구성요소 추가)
    - 병렬 환경 4개 (DummyVecEnv): 샘플 다양성 증가, 학습 속도 향상
    - VecNormalize (norm_reward=True): 보상 스케일 정규화로 학습 안정화
    - EvalCallback: 50k스텝마다 실제 성능 평가, best model 자동 저장
    - 학습률 선형 감소 스케줄 (3e-4→0): 후반부 안정적 수렴
    - ENT_COEF 분리: stage1=0.01(탐색), stage2=0.005(수렴)
    - BATCH_SIZE 64→256: 4개 환경 롤아웃에 맞게 조정
    - VecNormalize 통계 체크포인트와 동시 저장/로드
    - STAGE2_STEPS 1M→1.5M으로 증가
    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
2026-05-07 fix: 코드 검수 결과 버그 3건 수정
    - env_simple: BOARD_ORIGIN/CELL_SIZE/PIECE_Z 중복 정의 제거 → ik_solver에서 임포트
    - env_simple: TAU_OBS_LIMIT 모듈 상수화, observation_space q_real 범위 ±π+0.5로 확대
    (noise+action 적용 후 실제 최댓값 반영)
    - main.py: 하드코딩 3.0 → TAU_OBS_LIMIT 임포트, run_game을 try/finally로 감싸 리소스 해제 보장
    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
    [main.py]
2026-05-07 fix: MG996R 실제 스펙 기반 수치 전면 수정
    - URDF velocity 1.0→6.0 rad/s (MG996R 6V 실제 속도 7.5 rad/s, 부하 고려)
    - 링크 질량 m1=0.3→0.12, m2=0.2→0.08, m3=0.1→0.04 kg
    (MG996R 서보 55g + 3D프린트 링크 기반 추정)
    - lagrange.py / stl_to_urdf.py / env_full.py 세 파일 동기화
    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
2026-05-07 fix: EvalCallback eval_env VecNormalize 래핑 추가
    학습 env(VecNormalize)와 eval env(DummyVecEnv) 타입 불일치로
    AssertionError 발생 → eval env도 VecNormalize로 감싸되
    training=False, norm_reward=False 설정으로 실제 보상값 측정 유지
    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
2026-05-08 fix: 체크포인트 로드 시 하이퍼파라미터 강제 적용 + STAGE1 5M으로 증가
    PPO.load()가 저장 당시 고정 LR/ent_coef를 복원하는 문제 수정
    → 로드 후 linear_schedule, lr_schedule, ent_coef 명시적 덮어쓰기
    STAGE1_STEPS 3M→5M (버그 수정 후 처음부터 재학습 기준)
    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
2026-05-08 fix: 학습 정체 근본 원인 수정 및 코드 정리
    - NOISE_HIGH 0.05→0.03rad, FRICTION_HIGH 0.15→0.08rad (MG996R 현실 노이즈 상한)
    이전 파라미터는 관절당 최대 5.9cm 오차를 만들어 REACH_FINE=1cm 달성이 수학적으로
    불가능 → 3cm 평탄화가 학습 실패가 아닌 near-optimal 상태였음
    - REACH_FINE 0.010→0.020m (2cm): 수정된 노이즈 상한보다 크게 설정해 수렴 가능
    - OBS_Q_LIMIT 주석 수치 업데이트 (±0.05→±0.03, friction 0.15→0.08)
    - make_vec_env 미사용 dead code 제거
    - train_stage1/stage2에 try/finally로 env.close() 리소스 누수 방지
    - docstring 스텝 수 3M→5M 수정
    https://claude.ai/code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
2026-05-08 fix: env_full DR 노이즈 파라미터 현실화
    NOISE_HIGH_FULL 0.08→0.05rad, FRICTION_HIGH_FULL 0.30→0.12rad
    이전 값은 관절당 최대 11.2cm 오차 → REACH_FINE=2cm 수학적으로 불가능
    수정 후 최대 오차 ~5cm, 2단계 수렴 가능
    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
2026-05-08 fix: model.learn total_timesteps 버그 3개 및 sub-env 시딩 수정
    [버그 1] stage1 체크포인트 재개 시 목표 스텝 미달
    - remaining을 total_timesteps로 쓰면 SB3가 그 값에 도달하면 종료
    - 체크포인트 500K에서 재개 시: total=4.5M → 4.0M만 추가 학습 (총 4.5M, 목표 5M 미달)
    - 수정: total_timesteps=STAGE1_STEPS (절대 목표값)
    [버그 2] stage2 첫 시작 즉시 종료
    - model.num_timesteps=5M(stage1 완료), total_timesteps=STAGE2_STEPS=1.5M
    - 5M >= 1.5M → 한 스텝도 학습 안 하고 바로 종료
    - 수정: total_target = STAGE1_STEPS + STAGE2_STEPS, total_timesteps=total_target
    [버그 3] stage2 체크포인트 재개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
2026-05-08 fix: 보상 해킹(hover) 차단 — 보상 구조 재설계
    [근본 원인]
    success_rate가 0.4 → 0%로 폭락한 원인:
    - 맴돌기(2.1cm에서 150스텝): 150 × (+10+30+100-0.42) = 약 5,936점
    - 목표 도달(10스텝 후 종료): 10 × 보상 + 200 = 약 3,396점
    - 종료 안 하는 것이 2배 수익 → 정책이 목표 바로 바깥에서 의도적으로 머뭄
    [수정 내용]
    - 스텝별 임계값 보너스(+10, +30, +100) 제거: 호버링 수익원 차단
    - REACH_GOOD 상수 제거 (REACH_FINE과 동일값이어서 중복)
    - 종료 보너스: +300 + 남은스텝 × 3 (속도 인센티브 포함)
    - 스텝 패널티: -0.5/스텝 (오래 끌면 불리)
    - 진행 보너스: +3.0 (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
2026-05-08 tune: STAGE1_STEPS 5M→2M (1단계 조기 수렴 확인)
    1.3M 스텝에서 success_rate=1.0, mean_dist=1.2cm 달성으로
    1단계 수렴 완료 확인. 불필요한 3.7M 스텝 낭비 방지.
    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
2026-05-08 fix: stage2 시작 시 stage1_final 없으면 최신 체크포인트 fallback
    stage1을 중간에 중단하면 stage1_final.zip이 저장 안 됨.
    checkpoint 파일(stage1_N_steps.zip)이 있으면 그걸로 stage2 시작.
    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
2026-05-08 feat: --render 플래그로 PyBullet GUI 실시간 시각화 지원
    --render 옵션 추가 시 env[0]만 PyBullet GUI로 열고
    나머지 3개 환경은 headless 유지 (속도 저하 최소화)
    사용법:
    python sim/train_correction.py --stage 2 --render
    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
2026-05-08 feat: UDP 소켓 시각화 지원 (--vis-port, UE 연결 가능)
    - sim/vis_socket.py: UDP 송신기 (JSON: q, target, step)
    - env_simple/full: vis_port 파라미터 추가, step마다 관절각 송신
    - UE 미연결 시 sendto 즉시 반환 → 학습 속도 영향 없음
    - --render: PyBullet GUI, --vis-port 9001: 외부 뷰어(UE 등) 동시 사용 가능
    python sim/train_correction.py --stage 2 --render # PyBullet GUI
    python sim/train_correction.py --stage 2 --vis-port 9001 # UE UDP 연결
    UE 수신 프로토콜 (UDP 9001, JSON):
    {"q": [q1, q2, q3], "target": [tx, ty, tz], "step": N}
    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
2026-05-08 refactor: UE 코드 제거, STL 메시 자동 연결 구조 추가
    - sim/vis_socket.py 삭제
    - env_simple/full/train_correction에서 vis_port 파라미터 전부 제거
    - setup/meshes/ 디렉토리 생성 (STL 파일 보관 위치)
    - stl_to_urdf.py: meshes/에 STL 있으면 메시 URDF, 없으면 박스 URDF 자동 선택
    - STL 파일 넣은 뒤 python setup/stl_to_urdf.py 실행하면 PyBullet에서 실제 형상 표시
    STL 파일명 규칙:
    base_link.stl / link1.stl / link2.stl / end_effector.stl
    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
2026-05-08 feat: 조립된 STL 자동 분리 → 링크별 메시 URDF 생성
    assembled.stl 하나만 setup/meshes/ 에 넣으면:
    1. 연결 컴포넌트 분석으로 파츠 자동 분리 (Union-Find)
    2. Z축 중심 오름차순 정렬 → base_link/link1/link2/end_effector 순
    3. 각 파츠를 별도 STL로 저장 후 robot_full.urdf 메시 참조로 생성
    cp your_robot.stl setup/meshes/assembled.stl
    python setup/stl_to_urdf.py
    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
2026-05-08 fix: STL 파일명 assembled.stl → robot arm-1 assembly.stl
    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
2026-05-08 fix: render_mode mismatch AssertionError 수정
    SB3 DummyVecEnv는 모든 env의 render_mode가 동일해야 함.
    - 모든 env에 동일한 render_mode 전달
    - GUI 창 중복 방지: _gui_open 클래스 변수로 첫 번째 env만 p.connect(GUI) 사용
    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
2026-05-08 feat: PyBullet 시각화 개선
    - 카메라: 체스판 위 45도 내려보는 시점으로 초기화
    - 체스판 64칸 시각화 (흰/검 색상)
    - 목표 위치 빨간 구 마커 (에피소드마다 이동)
    - time.sleep(0.02) 으로 속도 제한 (~50fps)
    - 좌측 카메라 패널 숨김
    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
2026-05-08 feat: S키로 렌더링 속도 토글 기능 추가
    PyBullet GUI 실행 중 S키를 누르면 slow 모드(~50fps)와
    fast 모드(제한 없음)를 전환할 수 있음.
    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
2026-05-08 fix: S키 토글 연속 발화 버그 수정 (엣지 감지 방식으로 변경)
    KEY_WAS_TRIGGERED가 빠른 루프에서 연속 감지되어 껐다 켰다가 되지 않는
    문제를 _s_was_down 플래그로 직접 rising edge를 감지해 한 번만 토글하도록 수정.
    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
2026-05-08 fix: 속도 토글 에피소드 간 초기화 버그 + STL 메시 원점 정렬
    - env_simple: _slow_render/_s_was_down을 __init__으로 이동해 reset()마다
    slow 모드로 되돌아가던 버그 수정
    - stl_to_urdf: split_stl_components가 각 컴포넌트를 하단-중심 기준으로
    원점 정렬하여 저장 → URDF 로드 시 링크 프레임과 이중 오프셋 방지
    조립 좌표계 상 하단 위치(m)도 함께 반환
    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
2026-05-08 fix: generate_full_urdf 메시 이중 오프셋 수정 + __main__ STL 관절 위치 자동 추출
    - generate_full_urdf: mesh_centered=True 시 visual origin="0 0 0" 사용
    (split_stl_components가 메시를 원점 정렬했으므로 추가 오프셋 불필요)
    collision은 여전히 box로 단순화
    - __main__: split_stl_components의 attach_pts_m으로 URDF 관절 위치 자동 계산
    (하드코딩 joint_positions 대신 STL에서 추출한 값 사용)
    - env_simple: _slow_render 초기화 __init__으로 이동 (이전 커밋에서 누락된 변경)
    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
2026-05-08 feat: 화살표 키 카메라 회전 추가 + 조작법 안내 출력
    - 화살표 키 ←→: 좌우 회전 (yaw), ↑↓: 상하 틸트 (pitch)
    마우스 드래그가 시스템에서 캡처 안 되는 경우 대체 수단
    - 키보드 처리 로직을 _handle_keys() 메서드로 분리
    - 시작 시 조작법 안내 메시지 출력
    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
2026-05-08 feat: 로봇팔 시각화를 실린더+구 조합으로 개선 (발표/보고서용)
    - generate_simple_urdf: 박스 → 실린더(12mm 반지름) + 관절 구(18mm)
    - 링크별 색상: base=다크그레이, link1=파랑, link2=초록, end_effector=주황
    - 관절 위치를 노란 구로 명시적으로 표시
    - robot_simple.urdf, robot_full.urdf 재생성
    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
    [robot_full.urdf, robot_simple.urdf]
2026-05-08 fix: --render 시 env[0]만 sleep/GUI 처리 (학습 속도 저하 방지)
    render_mode="human"이어도 실제 GUI 창이 없는 env[1-3]까지
    time.sleep(0.02)를 실행해 학습이 4배 느려지던 버그 수정.
    _is_gui 플래그로 실제 GUI env[0]만 렌더링/키입력/슬립 처리.
    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
2026-05-08 feat: slow 모드에서 관절 보간으로 실제 서보 움직임 재현
    - _set_joint_angles(): slow 모드에서 현재→목표 각도를 ~60fps로 보간
    - MG996R 6 rad/s 기준으로 이동 각도에 비례한 소요 시간 계산
    - fast 모드: 기존처럼 즉시 이동 (학습 속도 최대)
    - slow 모드: 실제 서보처럼 부드럽게 이동 (발표/데모용)
    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
2026-05-08 fix: env_full 시각화를 robot_simple.urdf(실린더)로 교체
    robot_full.urdf의 STL 메시 좌표 불일치로 팔이 깨져 보이는 문제 해결.
    DR(노이즈/마찰/질량) 계산은 URDF와 무관하게 동작하므로 학습에 영향 없음.
    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
2026-05-08 perf: 회전 관절 인덱스 캐싱으로 학습 속도 개선
    _set_joint_angles()와 _randomize_link_masses()가 매 스텝마다
    getJointInfo()를 반복 호출하던 문제 수정.
    _revolute_indices를 초기화 시 한 번만 계산해 재사용.
    sphere 더미 관절 추가 후 총 7관절이 되면서 심화된 성능 저하 해소.
    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
2026-05-08 fix: RL 환경 코드 3개 버그 수정
    1. close()에서 _gui_open 플래그 미초기화 버그
    - stage1→stage2 연속 실행 시 --render GUI가 열리지 않던 문제 수정
    2. _compute_tau bare except 예외 silently 삼킴 → 경고 로그 추가
    3. 정의만 하고 미사용인 DELAY_LOW/HIGH 상수 제거
    (env_simple: DELAY_LOW/HIGH, env_full: DELAY_LOW_FULL/HIGH_FULL)
    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
2026-05-08 fix: TB 로거를 stage별 고정 폴더로 설정 (PPO_1/PPO_2 분산 방지)
    체크포인트에서 재시작할 때마다 SB3가 새 run 폴더(PPO_N)를 만들어
    TensorBoard에 데이터가 분산되던 문제 수정.
    tb_logs/stage1, tb_logs/stage2 폴더에 각 단계 로그를 일관되게 기록.
    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
2026-05-08 fix: DR 노이즈 스케일이 고정값이던 버그 수정
    uniform(abs(NOISE_LOW), NOISE_HIGH) = uniform(0.05, 0.05) = 상수
    → uniform(0.0, NOISE_HIGH) 으로 수정해 0~최대 범위 랜덤화
    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
2026-05-09 Tighten stage2 training: 1cm threshold, 3x noise, 200만 steps per stage
    - env_full: REACH_FINE_FULL=1cm (was 2cm), NOISE_HIGH_FULL=0.10 (was 0.05),
    FRICTION_HIGH_FULL=0.15 (was 0.12) — noise now large enough to exceed threshold
    - env_simple: _reach_fine instance variable so subclass can override;
    OBS_Q_LIMIT π+0.6 (was π+0.4) to avoid silent clipping with wider stage2 noise;
    reach_fine_cm added to info dict for dynamic threshold in metrics callback
    - train_correction: STAGE2_STEPS=2_000_000 (was 1_500_000);
    success_rate uses info["reach_fine_cm"] so stage1/stage2 are measured correctly
    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
2026-05-09 Add demo.py for visualizing trained PPO model in GUI
    Separate inference script that loads stage2_final (or best available
    checkpoint) and runs episodes with PyBullet GUI, slow-render mode,
    and per-episode success/distance logging.
    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
2026-05-09 Add showcase.py for presentation demo video
    IK-driven smooth movement between chess squares with ease-in-out
    interpolation, chess board visualization, and red target marker.
    Three modes: random squares, custom sequence, or chess opening demo.
    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
2026-05-09 showcase: auto-select mesh URDF, fallback to cylinder if missing
    Prefers robot_full.urdf (STL mesh) over robot_simple.urdf (cylinder).
    Added --urdf flag for manual override. Run setup/stl_to_urdf.py first
    to generate mesh URDF with correct local STL paths.
    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
2026-05-09 showcase: proper pick-place-return cycle per chess move
    Each move now: home→approach→pick→lift→carry→approach→place→lift→home
    Two markers (red=from, green=to) shown per move, hidden during home.
    Random mode generates 6 move pairs per cycle.
    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
2026-06-02 하드웨어 제어를 PCA9685 16채널 PWM 드라이버 방식으로 전환
    - Servo.h 직접 핀 제어 → Adafruit_PWMServoDriver(I2C) 기반으로 교체
    - joint1/2/3을 PCA 채널 0/1/2로, 펌프/밸브를 채널 3/4로 배치
    - 흡착기 비트 1개를 펌프+밸브 두 채널로 변환(집기=펌프ON/밸브닫힘,
    놓기=펌프OFF/밸브열림) → 시리얼 프로토콜 동일 유지로 파이썬 측 무수정
    - 서보 펄스폭(SERVO_MIN/MAX_PWM)·밸브 NC/NO 방향 캘리브레이션 주석 추가
    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
    [servo_control.ino]
2026-06-02 비전 디버그 좌표 오버레이 + 현장 배치 구조도 추가
    - detect.overlay_debug: 각 칸에 체스 좌표(a1~h8)·(col,row) 라벨 표시,
    a1(로봇 원점) 칸을 마젠타로 강조 → 카메라 회전/반전 검증 용이
    - calibrate.py 탑뷰 미리보기에 a1 원점 코너 힌트 추가
    - docs/make_layout.py: ik_solver 좌표 상수 기반 탑뷰+사이드뷰 배치 구조도 생성
    - docs/layout_diagram.png: 체스판/로봇팔/카메라/전원/배선 배치도
    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
2026-06-06 test_serial: 아두이노 READY 초기 메시지 버퍼 플러시 추가
    연결 시 아두이노가 보내는 "READY"가 버퍼에 남아
    OK 응답 대신 읽히던 오탐 수정.
    reset_input_buffer()로 명령 전송 전 버퍼를 비움.
    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
    [test_pipeline.py]
2026-06-06 arm_controller: 먼 칸 IK 실패 버그 수정 — 적응형 리프트 높이
    - 기존 LIFT_HEIGHT=0.10m 고정이라 h8, g8 등 먼 칸에서
    IK 도달 거리(0.298m) > 팔 길이(0.295m) 초과 오류 발생
    - _safe_lift() 함수 추가: 칸의 수평 거리에서 역산해
    IK가 성공하는 최대 높이를 계산, LIFT_HEIGHT와 비교해 작은 값 사용
    - 가까운 칸: 8.0cm, h8 같은 먼 코너: 5.3cm 자동 조정
    - 64칸 전체 IK 성공 검증 완료
    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
    [arm_controller.py]
2026-06-06 docs: 학교 노트북 현장 세팅 가이드(SETUP.md) 추가
    USB 준비물(stockfish.exe·RL모델·오프라인휠), 환경설치, 코드 받기,
    배선, 단계별 점검, 카메라 캘리브레이션·좌표검증, 서보/흡착 튜닝,
    최종 실행까지 처음부터 끝까지 정리. git으로 안 따라오는 파일
    (.zip 모델, calibration.json)을 명시.
    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
2026-06-15 베이스 서보 혼 조립 오차 보정 오프셋 추가
    A90,90,90 중립일 때 베이스가 +y(왼쪽)로 45도 틀어진 조립 오차를
    JOINT1_OFFSET_DEG로 보정. _rad_to_servo와 home() 양쪽에 적용.
    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
2026-06-15 서보 오프셋을 0으로 환원, 큰 오차는 혼 재장착으로 처리하도록 안내 수정
    45도/135도 같은 큰 조립 오차를 소프트웨어 오프셋으로 처리하면 서보
    가동범위(0~180)를 잡아먹어 체스판 칸을 못 짚게 됨. A90,90,90에서 혼을
    다시 끼워 기계적으로 맞추고, 잔여 미세 오차만 오프셋으로 조정하도록 변경.
    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
    [arm_controller.py]
2026-07-09 게임 시작/휴식 자세를 Z자 접힘(PARK_POSE)으로 변경
    home()이 무조건 수평 일자(90,90,90)로 가던 것을 Z자로 접힌 park 자세로
    변경. 수를 두는 사이 팔이 접혀 카메라 시야를 안 가리고 서보 토크 부하도
    줄인다. PARK_POSE 값은 실물 테스트로 미세조정하도록 상수화.
    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
2026-07-09 PPO.load에 custom_objects 추가 — sb3 버전 mismatch 로드 오류 해결
    학습 당시 sb3 버전과 실행 환경 버전이 달라 lr_schedule/clip_range 등
    스케줄 함수 역직렬화 시 'builtin_function_or_method * float' 오류 발생.
    custom_objects로 해당 스케줄을 무해한 람다로 대체해 로드가 성공하도록 함.
    predict에는 스케줄이 쓰이지 않으므로 추론 결과에는 영향 없음.
    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
2026-07-09 custom_objects에 learning_rate 키 추가 — 스케줄 대체가 실제로 적용되도록 수정
    학습률 스케줄은 sb3가 'learning_rate' 키로 저장하는데 이전 커밋은
    'lr_schedule'만 덮어 실제로는 깨진 함수가 그대로 호출됐음. cloudpickle이
    학습 함수를 값으로 저장해 다른 머신 경로(hjh vs hjh20)에서 호출 시
    TypeError 발생. learning_rate/lr_schedule/clip_range를 무해한 상수로 대체.
    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
    [main.py, test_pipeline.py]
2026-07-10 pybullet을 requirements에서 분리 (requirements-sim.txt로 이동)
    Windows에서 pybullet은 wheel이 없으면 MSVC 컴파일이 필요해 설치가
    실패하고, requirements.txt 맨 위에 있어 나머지 패키지 설치까지 전부
    중단시켰음. 실제 로봇 작동·RL 보정·시리얼엔 pybullet이 불필요하므로
    핵심 패키지만 requirements.txt에 남기고 pybullet은 별도 파일로 분리.
    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
2026-07-10 requirements 주석을 ASCII(영문)로 변경 — 한국어 Windows cp949 디코딩 오류 수정
    pip가 한국어 Windows 로케일(cp949)로 requirements.txt를 읽는데 한글 주석
    UTF-8 바이트에서 UnicodeDecodeError 발생. 주석을 영문으로 바꿔 어떤
    로케일에서도 파싱되도록 함.
    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
2026-07-10 서보 캘리브레이션을 HOME+DIR 방식으로 일반화 + 조그 도구 추가
    혼 재장착이 불가능한 경우를 위해, 각 관절의 IK 기준자세(q=0)에 대응하는
    서보 각도(SERVO*_HOME)와 회전 방향(SERVO*_DIR)을 상수로 노출. 실물에서
    값만 찾아 넣으면 소프트웨어로 마운팅 오차를 보정. servo_jog.py로 각도를
    대화식으로 보내며 HOME 값을 쉽게 탐색.
    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
2026-07-10 아두이노 타임아웃 자동 중립복귀 제거 — 마지막 명령 위치 유지
    5초 무명령 시 goNeutral()로 90,90,90 복귀하던 안전 타임아웃이 조그
    캘리브레이션과 게임 중 park 자세 유지를 방해함. 제거하여 서보가 마지막
    명령 위치를 그대로 유지하도록 변경.
    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
2026-07-14 정적분 발표용 운동 데이터 수집·분석 도구 추가
    collect_motion.py: 말단을 A->B로 사다리꼴 속도프로파일(가속-등속-감속)로
    이동시키며 고정 dt마다 (t, 관절각, 말단xyz, 명령속도)를 CSV로 기록.
    integrate.py: 속도 로그를 구분구적(왼쪽/오른쪽/중점/사다리꼴)으로 적분해
    예측 이동거리 산출, 자로 잰 실측거리와 비교, dt를 줄일수록 참값에 수렴함을
    시연. 로그의 위치·속도는 명령값임(개방루프 서보, 피드백 없음)을 명시.
    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
2026-07-14 조그를 부드러운 램프 이동으로 변경 — 서보 스톨/충격 방지
    기존 조그는 목표 각도로 즉시 최고속 슬램해 관성 충격·스톨 위험이 있었음
    (플라스틱 기어 손상 사고). 목표까지 --step(기본 2도)씩 나눠 이동하도록
    변경. 긁는 소리 시 Ctrl+C로 현재 위치에서 즉시 정지 가능.
    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
2026-07-14 게임 이동을 램프(부드러운) 이동으로 + 관절별 소프트 각도 제한 추가
    1) execute_move/home/move의 즉시 슬램을 RAMP_STEP_DEG(기본4도)씩 나눠
    목표까지 부드럽게 이동하도록 변경 — 관성 충격·스톨로 인한 기어 손상 방지.
    현재 위치(_cur)를 추적해 램프 출발점으로 사용.
    2) SERVO_SAFE_MIN/MAX로 관절별 소프트 각도 제한 추가. 팔이 테이블·구조물에
    처박히는 각도를 아예 차단하고, 제한에 걸리면 경고 출력. 기본은 전 범위라
    실물에서 안전 범위를 확인해 좁혀 넣으면 됨.
    sim 및 test_pipeline --test full 통과 확인.
    https://claude.ai/code/sessi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
2026-07-14 서보 각도 한계를 180->200으로 확장(옵션) — 초과분만 외삽, 펄스 상한 추가
    s2 등 일부 관절이 180도 이상 더 꺾여야 하는 경우를 위해:
    - .ino: ANGLE_HARD_MAX=200 허용, angleToPulse는 0~180을 기존 스케일로
    고정하고 180 초과만 같은 기울기로 외삽, SERVO_PWM_CEIL=560으로 과구동 상한.
    0~180 동작은 완전히 동일.
    - servo_jog.py: --max-angle 옵션(기본180, 최대200)으로 확장 범위 opt-in.
    ⚠️ 180 초과는 서보 하드 스톱 스톨 위험이 있어 조금씩 올리며 확인해야 함.
    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
2026-07-14 조그 suction 명령 입력오류 수정
    'suction'이 's'로 시작해 s1/s2/s3 분기가 먼저 가로채 int('u')에서 오류
    발생. 서보 분기 조건을 s1/s2/s3 정확 매칭으로 좁혀 suction 명령이 제대로
    동작하도록 수정.
    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
    [servo_jog.py]
2026-07-14 조그 suction 명령도 응답 출력 — 무반응처럼 보이던 표시 버그 수정
    suction 분기가 _send_now() 결과를 출력하지 않아 명령이 전송돼도 화면에
    아무것도 안 떠 '무응답'처럼 보였음. 전송 명령과 아두이노 응답을 출력하도록
    수정. (실제 명령은 정상 전송되고 있었음)
    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
    [servo_jog.py]
2026-07-14 조그 종료 시 홈복귀 제거 — 마지막 각도 그대로 유지
    q로 종료할 때 90,90,90으로 되돌리던 것을 제거. 아두이노 타임아웃도
    없앴으므로 포트를 닫아도 서보가 마지막 명령 위치를 유지한다. 캘리브레이션
    중 찾은 각도를 그대로 두고 관찰/측정할 수 있음.
    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
2026-07-14 펌프/밸브 채널을 CH5/CH6으로 변경 (실제 배선 반영)
    실제 배선이 펌프=ch5, 밸브=ch6이라 CH_PUMP=5, CH_VALVE=6으로 수정.
    .ino 주석과 SETUP.md 배선표도 함께 갱신.
    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
    [servo_control.ino]
2026-07-14 펌프/밸브 채널을 CH4/CH5로 정정 (실제 배선)
    펌프=ch4, 밸브=ch5로 수정. .ino 주석과 SETUP.md 배선표 갱신.
    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
    [servo_control.ino]
2026-07-14 펌프/밸브를 서보 펄스 신호로 제어 (FZ006 스위치 모듈에 맞춤)
    펌프/밸브 제어 모듈이 서보 3선(신호/V+/GND) 입력의 RC 전자스위치류라,
    상시 HIGH(duty 4095)가 아니라 서보 펄스(펄스폭)로 켜고 꺼야 함. ON은
    SERVO_MAX_PWM(약 2.4ms), OFF는 SERVO_MIN_PWM(약 0.5ms)로 변경. 반대로
    동작하면 DEV_ON/OFF_PULSE를 서로 바꾸면 됨.
    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
2026-07-14 하드웨어 격리 진단 도구 추가 (diagnose.py)
    부품을 하나씩만 작동시켜 어디서 전원이 죽는지(과전류 차단) 좁혀내는
    대화식 진단. 통신/서보 개별/펌프 단독/펌프+서보 동시 테스트 후, 관찰
    결과로 원인(펌프 인러시 / 합산 과전류 / 접촉불량 / 통신)을 요약 해석.
    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
2026-08-04 흡착기 단독 테스트 도구 추가 (test_suction.py)
    펌프/밸브만 on/off/pulse로 토글하는 대화식 테스트. 서보 분리 상태에서
    흡착 회로만 격리 테스트하도록 안내. 종료 시 자동 OFF.
    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
2026-08-04 SETUP.md 전면 개정 — 새 도구·트러블슈팅·컴퓨터전용 작업 반영
    추가/갱신 내용:
    - 하드웨어 없이 컴퓨터만으로 가능한 작업 목록 (신규 0장)
    - Python 3.11/3.12 필수 경고 (3.13+ wheel 부재로 설치 실패)
    - 도구 레퍼런스: servo_jog / test_suction / diagnose / analysis 사용법
    - 배선 갱신: 펌프 ch4·밸브 ch5, 펌프 V+ 외부전원 직결 필수 경고
    - 흡착 모듈이 서보 펄스 방식임을 명시
    - 서보 캘리브레이션 절차 (HOME/DIR/SAFE/PARK)
    - 조정 상수 한눈에 표
    - 트러블슈팅 표 (설치·시리얼·전원·동작 4개 분류, 그동안 겪은 문제 전부)
    - 점검 순서를 안전 우선(흡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
2026-08-04 잡은 기물 놓는 위치를 도달 가능한 캡처 구역으로 수정 (IK 크래시 해결)
    기존에는 잡은 칸에서 x+5cm 지점에 내려놓았는데, h1 같은 먼 칸에서는
    그 위치의 반경이 0.301m로 팔 길이 0.295m를 넘어 z와 무관하게 IK가
    실패하고 게임이 크래시했다(e4h1 기물잡기에서 재현).
    - 보드 밖(y 음수)·베이스 근처의 고정 캡처 구역(4x2 슬롯)에 순서대로 배치
    - 리프트도 고정값 대신 _safe_lift_xy로 적응형 계산
    - main.py: execute_move의 ValueError를 잡아 게임이 통째로 죽지 않도록 방어
    검증: 64칸 전체 + 캡처슬롯 32회 IK 전수 통과, 슬롯이 보드 영역과 겹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
    [arm_controller.py, main.py]
2026-08-04 시작 시 서보 슬램 방지 — 부팅 중립복귀 제거 + 시작 위치 지정
    전원을 끈 채 팔을 손으로 옮긴 뒤 연결하면, 아두이노 setup()의 goNeutral()과
    조그의 초기 전송이 실제 위치와 90도의 차이만큼 전속력으로 튀게 만들었다.
    - .ino: 부팅 시 서보 채널 출력을 끈 상태(무부하)로 두고 첫 A 명령부터 제어.
    펌프/밸브만 확실히 OFF.
    - servo_jog.py: 시작 시 아무 명령도 보내지 않음. --start 로 실제 각도를
    알려주거나, 대화식 'set s1 s2 s3'로 이동 없이 현재 위치 가정만 교정.
    - arm_controller.py: RealArm(start_pose=...) 추가. 미지정 시 PARK_POSE 가정.
    검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
2026-08-04 보드 방향을 ROBOT_SIDE로 설정 가능하게 + 좌표계 거울상 버그 수정
    실제 배치에서 캘리브레이션 코너 3·4 변이 로봇과 가까운 쪽인데, 코드는
    코너 1(좌상)을 a1으로 가정하고 있었다. 또한 기존 매핑(col=gx, row=gy)은
    로봇 좌표계와 손대칭이 반대인 거울상이어서, 방향을 맞춰도 좌우가 뒤집혔다.
    - vision/detect.py: ROBOT_SIDE(bottom/top/left/right)와 chess_to_grid()를
    추가. get_board_state가 체스/로봇 좌표로 인덱싱된 보드를 반환하고,
    overlay_debug도 같은 매핑으로 라벨을 배치. 현재 배치에 맞춰 bottom 기본값.
    - vision/calibrate.py: 미리보기 힌트를 'a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
    [calibrate.py, detect.py]
2026-08-04 ROBOT_SIDE를 left로 설정 + 캘리브 힌트를 설정값에 자동 연동
    실제 배치에서 로봇팔이 카메라 뷰 왼쪽(코너 1·4 변)에 있어 ROBOT_SIDE를
    left로 변경. calibrate.py의 방향 힌트가 detect.py의 ROBOT_SIDE를 직접
    읽어 로봇 쪽 변과 a1 위치를 그리도록 수정 — 설정을 바꿔도 힌트가
    어긋나지 않는다.
    left 기준: a1=탑뷰 좌하, 파일 a→h는 오른쪽, 랭크 1→8은 위쪽.
    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
    [calibrate.py, detect.py]
2026-08-04 캘리브레이션에 --click centers 모드 추가 (모서리 칸 중앙 클릭 지원)
    모서리 칸의 '중앙'을 클릭하면 중앙끼리는 7칸 거리인데 코드가 8칸으로
    나누어 전체 격자가 1/8씩 어긋났다. 보드 테두리가 둥글어 바깥 모서리를
    정확히 찍기 어려운 경우를 위해, 칸 중앙 4점에서 호모그래피로 칸 단위
    좌표계를 세우고 8x8 바깥 모서리를 역변환해 자동 계산하는 모드를 추가.
    - --click corners (기본): 기존대로 바깥 모서리 클릭
    - --click centers: 모서리 칸 중앙 클릭 → 바깥 모서리 자동 계산
    - centers 모드에서 계산된 8x8 경계를 화면에 청록색으로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
2026-08-04 보드 좌표 규약 수정 — 랭크를 로봇↔사람 방향으로 (게임 진행 불가 버그)
    chess_square_to_xyz가 파일(a~h)을 로봇에서 멀어지는 방향(x)에, 랭크를
    좌우(y)에 배치하고 있었다. 이 배치에서는 사람 앞 두 줄이 랭크1·2가 아니라
    g·h 파일이 되어, 사람(WHITE)이 실제로 둔 수를 엔진이 전부 불법으로
    판정하고 폰 전진 방향도 맞지 않는다.
    - utils/ik_solver.py: 랭크를 로봇↔사람 방향(x)으로, 파일을 좌우(y)로 변경.
    랭크8=로봇 쪽, 랭크1=사람 쪽, 파일a=로봇 기준 오른쪽.
    - vision/detect.py: 새 규약에 맞춰 chess_to_grid의 네 방향 매핑을 재도출.
    R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
    [detect.py]
2026-08-04 칸 단위 동작 테스트 도구 추가 (test_square.py)
    servo_jog는 서보 각도를, 이 도구는 체스 좌표를 다룬다. 칸 이름(e4)을
    입력하면 IK로 계산해 팔을 보내므로 SERVO*_HOME 캘리브레이션과 체스판
    물리 배치가 맞는지 검증할 수 있다. 조그와 실전 게임 사이의 중간 단계.
    명령: <칸> / down / up / pick / place / move / home
    목표 좌표(cm)와 계산된 서보각을 함께 출력해 어긋남을 진단하기 쉽게 함.
    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
2026-08-04 IK에 어깨 높이·팔꿈치 자세 파라미터 추가 + 실측 캘리브레이션 반영
    실측한 서보값(수직자세 s2=80, 팔꿈치 일직선 s3=50)으로 계산해 보니 기존
    IK(elbow-up)로는 두 관절 모두 서보 범위를 벗어나 체스판에 닿을 수 없었다.
    원인은 IK 모델에 빠져 있던 두 파라미터였다.
    - SHOULDER_HEIGHT: 어깨 관절이 체스판 표면보다 높은 거리. 기존 코드는 이
    항이 없어 어깨가 보드면과 같은 높이라고 가정했다. FK에도 반영.
    - ELBOW_SIGN: 2링크 IK의 두 해(elbow-up/down) 중 실물 관절 방향과 서보
    가동범위에 맞는 쪽을 고르는 스위치. 실측값 기준 elbow-do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
2026-08-04 실측 제원 반영 + 도달범위 최적 배치 (중앙·흑진영 전부 도달)
    측정값 반영: 어깨높이 8.9cm, 기물 7mm, 베이스 정면 s1=38.
    이 조건으로 기존 배치(보드 앞단 1.5cm)를 계산하니 중앙 4x4 중 9칸만
    닿았다. 보드 위치를 탐색해 근단 x=11cm, 우단 y=-6cm로 옮기니 중앙 4x4와
    랭크7-8(흑=로봇 기물) 전부 도달 가능해졌다(46/64).
    - ik_solver: SHOULDER_HEIGHT=0.089, PIECE_Z=0.007, LIFT_DEFAULT=0.04,
    BOARD_ORIGIN을 최적 배치로 갱신.
    - arm_controller: LIFT_HEIGHT/MIN을 기물 높이에 맞게 축소.
    캡처 구역을 보드 왼쪽(+y) 도달 가능 위치로 이동(8/8 도달).
    - _rad_to_servo: 서보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
2026-08-04 PARK_POSE를 실측 Z자(38,140,180)로 수정 + 이동 속도 완화·조절 가능화
    시작 시 팔이 이상한 각도로 빠르게 튀던 원인은 PARK_POSE가 옛 추정치
    (90,45,135)로 남아 있었기 때문. RealArm은 초기화 시 home()으로 PARK_POSE에
    가는데, start_pose 미지정이면 _cur가 PARK_POSE와 같아 램프 없이 단일
    명령으로 전송되어 실제 물리 위치에서 그 각도까지 한 번에 슬램했다.
    - PARK_POSE = (38,140,180) — 실측 Z자 휴식 자세
    - 기본 램프 속도 완화: 4도/0.015s → 2도/0.05s (약 25~30°/초)
    - RealArm에 ramp_step/ramp_delay 인자 추가, 인스턴스별 속도 조절 가능
    - test_square.py / main.py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
    [arm_controller.py, main.py, servo_jog.py, test_square.py]
2026-08-04 test_square 시작 시 자동 이동 제거 + set 명령·오류 안내 개선
    1) 첫 실행이 빠른 문제: 아두이노가 부팅 시 서보를 잡지 않아(슬램 방지 조치)
    팔이 중력으로 처지고, 그 상태에서 첫 명령이 나가면 서보가 자기 최대
    속도로 되돌아간다. 출발 위치를 모르므로 이 첫 동작만은 램프로 늦출 수
    없다. RealArm에 auto_home 인자를 추가하고 test_square는 False로 두어,
    시작 시 아무 명령도 보내지 않고 사용자가 시점을 고르도록 했다.
    'set s1 s2 s3'로 실제 위치를 알려주면 그 지점부터 램프가 적용된다.
    2) up/down이 칸 지정 없이 입력되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
2026-08-04 안전 기동 절차(interactive_startup) 추가 — 첫 슬램 근본 해결
    서보는 명령받은 위치로 자기 최대 속도로 가므로, 출발 위치를 모르면 첫
    동작을 램프로 늦출 수 없다. 부팅 직후엔 서보가 무부하라 팔이 처져 있어
    첫 명령마다 슬램이 발생했다.
    해결: 사용자가 현재(처진) 각도를 알려주면 그 값을 그대로 보내 서보에
    '힘만' 들어오게 하고(움직임 없음), 이후 조그 명령으로 PARK까지 램프로
    천천히 올린 뒤 start로 완료를 선언하는 대화식 절차를 추가.
    engage <s1> <s2> <s3> 현재 각도 고정 (안 움직임)
    <a b c> / s2 120 램프 이동
    par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
2026-08-04 engage를 인자 없이 쓰면 PARK로 간주 — 손으로 잡고 기동하는 절차 단순화
    처진 각도를 측정하지 않아도 되도록, 팔을 손으로 Z자 자세로 잡은 채
    'engage'만 입력하면 PARK_POSE로 선언되도록 함. 실제와 명령이 일치하므로
    서보가 움직이지 않는다. engage 값이 실제와 다르면 그만큼 튄다는 점도
    안내 문구에 명시.
    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
2026-08-04 펌웨어 버전 확인 추가 — .ino 재업로드 누락을 자동 감지
    부팅 시 서보를 90,90,90으로 보내던 동작을 .ino에서 제거했지만, 아두이노에
    재업로드하지 않으면 구버전이 계속 그 동작을 해 팔이 전속력으로 튄다.
    파이썬 쪽에서는 이를 알 방법이 없어 원인 파악이 어려웠다.
    - .ino: FW_VERSION 정의, READY 메시지에 'fw=<버전>' 포함
    - arm_controller: 연결 시 배너에서 버전을 읽어 EXPECTED_FW와 대조하고,
    다르거나 없으면 재업로드하라는 경고를 크게 출력
    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
2026-08-04 이동 중 흡착이 풀리던 버그 수정 — 기물을 집자마자 떨어뜨림
    _move_to()와 goto()가 suction 인자를 받지 않아 매 호출마다 기본값 False로
    덮어썼다. 그래서 흡착 ON 직후 '안전 높이로 상승' 단계에서 곧바로 흡착이
    풀려 기물이 제자리에 떨어졌다. 기물 잡기 시퀀스에서도 캡처 구역으로
    옮기기 전에 놓아버렸다.
    - arm_controller.execute_move: _move_to에 suction 인자 추가. 집은 뒤
    상승·이동·하강 전 구간에 suction=True를 명시적으로 전달. 놓는 지점은
    7단계(도착 칸 하강 후) 한 곳뿐이 되도록 정리.
    - test_square: goto에 suction 인자 추가, holding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
    [arm_controller.py, test_square.py]
2026-08-04 suction 명령이 팔을 움직이던 버그 수정 + 하강 깊이(TOUCH_PRESS) 도입
    1) test_square의 'suction 0/1'이 흡착만 토글하지 않고 리프트 좌표로
    이동해 팔이 위로 올라갔다. 현재 서보 각도를 그대로 재전송하도록 수정.
    2) 흡착컵은 고무라 기물에 살짝 눌려야 진공이 걸리는데, 하강 목표가 기물
    윗면(PIECE_Z) 정확히여서 밀착이 안 됐다. TOUCH_PRESS(기본 4mm)만큼 더
    내려가도록 touch_xyz()를 추가하고 집기/놓기 하강 경로에 적용.
    어깨높이·링크길이 실측 오차도 이 값으로 함께 흡수한다.
    test_square에 'zoff <mm>' 명령을 추가해 실시간으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
    [arm_controller.py, test_square.py]
2026-08-04 SETUP.md에 신규 기능·절차 정리 (기동 절차·test_square·속도·배치·상수)
    이번 세션에서 추가/변경된 내용을 문서에 반영:
    - 6장: .ino 재업로드 판단 기준표 + 펌웨어 버전 자동 확인(fw=3)
    - 8-A장(신규): 기동 절차(engage/park/start) — 첫 동작 슬램의 원인과 대처
    - 8-B장(신규): --step/--step-delay 의미와 설정별 실제 속도표
    - 9-2A(신규): test_square.py 명령 레퍼런스, zoff로 하강 깊이 맞추는 법
    - 10-2: 실측 확정된 캘리브레이션 값(SERVO*_HOME/PARK_POSE) 기재,
    기준자세를 직접 만들지 않고 환산하는 요령 추가
    - 10-3(신규): 체스판 물리 배치 좌표와 도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
2026-08-04 RL 학습 환경이 chess_square_to_xyz를 쓰도록 통일
    env_simple이 보드 좌표를 옛 규약(x=col, y=row)으로 직접 계산하고 있었다.
    좌표 규약을 바꾼 뒤라 코드가 불일치 상태였다(샘플링되는 64개 점의 집합은
    같아 학습 결과에는 영향 없었으나, 이후 규약이 또 바뀌면 어긋난다).
    chess_square_to_xyz를 호출하도록 바꿔 한 곳에서만 관리되게 함.
    아두이노 재업로드: 불필요 (파이썬만 변경).
    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
2026-08-04 학습 속도 측정 도구 추가 (sim/benchmark.py)
    재학습에 몇 시간 걸릴지는 CPU 성능에 크게 좌우되는데(물리 시뮬이 CPU에서
    돌고 정책망이 작아 GPU 이득이 거의 없다) 사양만으로는 추정이 어렵다.
    PPO 학습 루프를 짧게 돌려 실제 FPS를 재고 목표 스텝별 예상 시간을
    출력하는 도구를 추가. 2~3분이면 자기 컴퓨터 기준 수치를 얻을 수 있다.
    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
2026-08-04 실측 기반 보드 보정 추가 (calibrate_board.py + board_fit.json)
    시뮬 RL은 실제 로봇을 본 적이 없어 실제 오차를 줄일 수 없다. 진짜 보정은
    실제 오차를 측정해야 가능한데, 카메라로 재면 카메라 캘리브레이션 오차가
    측정에 섞인다. 대신 체스판에 인쇄된 격자를 눈금으로 써서 사람이 읽는다
    (한 칸 29.1mm라 2~3mm까지 판독 가능, 로봇 오차 1~2cm 대비 충분).
    - calibrate_board.py: 여러 칸으로 팔을 보내고 벗어난 양을 mm로 입력받아
    최소제곱으로 어파인 보정식(밀림·축척·기울어짐)을 구해 저장. 기물이나
    흡착 성공이 필요 없어 빠르다(6~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
2026-08-04 SETUP.md에 정확도 보정 두 방법 정리 (9-A장 신규)
    실측 보정과 시뮬 RL 재학습은 이름이 비슷하지만 성격이 완전히 달라
    혼동하기 쉬우므로 대조표와 함께 한 장으로 묶었다.
    - 9-A: 두 방법 비교표 (무엇을 학습하나 / 실제 정확도 개선 여부 / 소요 시간)
    및 보고서 구성 제안(둘 다 하고 비교하는 것이 정직하고 내용도 좋다)
    - 9-A-1: calibrate_board.py 실측 보정 절차 — 카메라를 쓰지 않는 이유,
    부호 규칙, 입력 형식, 결과 해석, 보정 끄는 법
    - 9-A-2: RL 재학습 — 기존 모델을 못 쓰는 이유(관절각 범위 비중첩),
    benchmark로 시간 먼저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
2026-08-05 정밀 동작 전 정착 대기(SETTLE_WAIT) 추가 — 팔 잔류 진동 대응
    영상 분석 결과 팔의 흔들림이 약 3~4Hz의 구조 고유진동으로 확인됐다
    (초록 베이스를 기준점으로 카메라 손떨림을 제거하고 팔 끝의 상대 운동을
    FFT 분석). 서보 지터가 아니라 링크·마운트가 휘어 생기는 저주파 진동이라,
    이동을 멈춰도 몇 주기 더 흔들린다. 흔들리는 상태로 하강하면 흡착컵이
    기물 중심을 벗어난다.
    하강 직전과 흡착/해제 직전에 SETTLE_WAIT(기본 0.4초) 대기를 넣어
    진동이 감쇠한 뒤 정밀 동작을 하도록 함. execute_move와 test_square의
    pick/place 모두 적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
2026-08-05 Colab에서 이미 마운트된 드라이브를 인식하도록 수정
    '!python train_correction.py' 로 실행하면 별도 프로세스라 drive.mount()가
    노트북 커널에 접근하지 못해 실패한다(NoneType has no attribute 'kernel').
    그 결과 조용히 로컬(Colab 임시 디스크)에 저장되는데, 세션이 끝나면 학습
    결과가 사라진다.
    - /content/drive/MyDrive 가 이미 있으면 mount() 호출 없이 그 경로를 사용
    - 마운트 실패 시 세션 종료로 파일이 사라진다는 점과 대처법을 안내
    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
2026-08-05 보고서용 정리 추가 — 설계(PPT) 대비 실제 구현 변경점 및 소감
    발표 PPT의 설계안과 실제 코드를 대조해 정리:
    - 계획대로 된 것 / 달라진 것 / 미완 / 새로 필요했던 것으로 분류
    - 체스 엔진 Lc0→Stockfish, 응답시간 1.7초→20~30초(안전 우선), 프로토콜,
    PCA9685 도입 등 설계 변경과 그 사유
    - IK 모델에 빠져 있던 SHOULDER_HEIGHT·ELBOW_SIGN, 좌표계 거울상·축반전 등
    실물 제작 후에야 드러난 문제들
    - 기존 RL 모델을 쓸 수 없게 된 경위를 관절각 범위 수치와 함께 정직하게 기록
    - 소감 초안 (실제 겪은 사건에 근거)
    아두이노 재업로드: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
2026-08-05 pick/place에 하강 전 확인 단계 + 도달 지도 check 명령 추가
    1) 실측 보정을 적용하면 보정식이 가장자리 칸을 서보 범위 밖으로 밀어내
    a8 같은 칸이 아예 도달 불가가 되는 일이 생긴다. 어느 칸이 닿는지 언제든
    확인할 수 있도록 test_square에 'check' 명령을 추가(보정 적용 여부도 표시).
    calibrate_board도 피팅 직후 도달 불가가 된 칸을 경고하도록 함.
    2) 팔이 천천히 움직이므로, pick/place에서 칸 위 안전높이에 멈춰 흡착컵이
    기물 바로 위인지 눈/카메라로 확인한 뒤 하강하도록 변경. Enter로 진행,
    x로 취소, 칸 이름을 입력하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
2026-08-05 카메라 폐루프 위치 보정 추가 (visual_align)
    결합부 유격 때문에 오차가 매번 달라지므로, 미리 구한 고정 보정식만으로는
    한계가 있다. 흡착컵에 붙인 색 마커를 카메라로 보고 '실제로 어디에 가 있는지'
    측정해 그만큼 다시 움직이는 폐루프 방식을 추가했다.
    - vision/detect.py: grid_uv_to_colrow() 로 탑뷰 픽셀→연속 체스 좌표 역변환
    (ROBOT_SIDE 4방향 모두 지원), find_marker()로 마커 검출,
    디버그 뷰에 마커 표시(색 범위 튜닝용)
    - hardware/visual_align.py: 목표 칸 위에서 오차만큼 재이동하는 반복 정렬.
    발산 감지·도달 불가 처리·최대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
2026-08-05 마커 기본색을 빨강으로 변경 + 마커 오프셋 보정 기능 추가
    흡착기 마운트에 이미 빨간 점퍼선이 감겨 있어 별도 부착물 없이 그대로
    마커로 쓸 수 있다. 빨강은 HSV 색상환에서 H=0을 넘나들므로 두 구간으로
    나눠 등록.
    마커가 흡착컵 중심 바로 위가 아닐 수 있으므로 MARKER_OFFSET_COL/ROW로
    그 차이를 보정한다. test_square에 측정 명령을 추가:
    - markcal <칸> : 흡착컵을 그 칸 중심에 맞춰 둔 상태에서 실행하면 오프셋 계산
    - mark : 현재 마커 위치 확인 (색 튜닝용)
    https://claude.ai/code/sess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
2026-08-05 카메라 워밍업·마커 재시도 추가 + 실패 원인 안내
    --mode vision 에서는 마커가 잡히는데 test_square 에서는 못 잡는 현상.
    원인 두 가지를 모두 보완:
    1) USB 카메라는 한 번에 한 프로그램만 열 수 있다. vision 창이 떠 있으면
    test_square는 프레임을 못 받는다 → 실패 메시지에 이 점을 명시.
    2) 카메라를 막 열면 자동노출·화이트밸런스가 잡히기 전이라 첫 프레임이
    어둡거나 색이 틀어져 마커를 놓친다 → 초기화 시 8프레임 워밍업,
    find_marker는 새 프레임을 받아가며 최대 5회 재시도.
    아두이노 재업로드: 불필요 (파이썬만 변경).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
2026-08-05 마커 색을 노랑으로 변경 + 체스판 오인식 방지
    노란 마커는 체스판 밝은 칸(연한 나무색)과 색상(H)이 겹친다. 구분은
    채도(S)로 한다 — 나무색은 채도가 낮고 형광 노랑은 높다. S 최소값을
    130으로 높게 잡았다.
    추가로 MARKER_MAX_AREA(1200px)를 두어, 한 칸(2500px)의 절반이 넘는
    덩어리가 잡히면 보드나 조명 반사를 오인한 것으로 보고 '마커 없음'으로
    처리한다. 엉뚱한 위치로 보정되는 것을 막는다.
    test_square의 mark 명령이 검출 크기를 함께 출력하고, 실패 시 원인
    (너무 큰 덩어리 = 채도 올릴 것 / 카메라 점유 / 색 범위)을 구분해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
2026-08-05 test_square 자체에서 카메라 화면을 볼 수 있게 show/view 명령 추가
    --mode vision을 별도로 켜면 카메라를 두 프로그램이 동시에 못 써 충돌했다.
    test_square가 이미 카메라를 열고 있으므로, 자기 자신이 보는 화면(마커
    표시 포함)을 cv2 창으로 띄우면 별도 프로세스 없이 실시간으로 볼 수 있다.
    - show(=view): 현재 프레임을 창으로 띄움
    - align()/mark 호출 시 자동으로 창 갱신
    - 종료 시 cv2 창 정리
    이제 test_square 하나만 켜둔 채로 마커 정렬 과정을 직접 보면서 진행할 수
    있다.
    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
2026-08-05 라이브 뷰가 '응답 없음'으로 멈추던 문제 수정
    cv2.imshow 후 waitKey를 한 번만 호출하고 input()으로 넘어가면 GUI 이벤트
    루프가 돌지 않아 Windows에서 창이 응답 없음 상태가 된다.
    - show [초] : 지정 시간 동안 이벤트 루프를 직접 돌리는 라이브 뷰.
    아무 키나 누르면 즉시 종료 (기본 8초)
    - show_once : 이동·정렬 중 한 프레임만 갱신 (waitKey를 여러 번 호출해
    실제로 그려지게 함)
    - align_over_square에 view_cb 인자를 추가해 정렬 매 반복마다 화면 갱신
    https://claude.ai/code/session_01LH4EnHTZqRnCXBSVhiNqwi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
    [test_square.py, visual_align.py]
2026-08-05 라이브 뷰를 백그라운드 스레드로 — 창을 띄운 채 계속 명령 가능
    input()이 블로킹이라 메인 스레드에서는 GUI 이벤트를 돌릴 수 없어, 이전
    구현은 정해진 시간만 라이브로 보여주고 끝났다. 별도 스레드가 read→그리기
    →waitKey를 반복하도록 바꿔 창을 띄운 채로 계속 명령할 수 있게 했다.
    카메라를 두 곳에서 읽으면 프레임을 서로 뺏으므로, 뷰 스레드가 읽기를
    독점하고 최신 프레임을 보관한다. 마커 검출은 _DetProxy를 통해 그 프레임을
    재사용한다(뷰가 꺼져 있으면 기존대로 직접 읽음).
    show / show on 라이브 뷰 켜기 (창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
2026-08-05 보드 읽기 전 팔을 PARK로 물리고, 안정된 프레임만 채택
    로봇팔이 보드 위에 있으면 카메라를 가려 기물 인식이 깨진다. 실제 게임에서
    보드를 읽는 시점은 사람이 수를 둔 뒤뿐이고 그때 팔은 PARK에 있어야 하지만,
    코드로 보장되지 않고 있었다.
    - main.py: 사람 수를 읽기 직전에 arm.home()으로 팔을 물린다
    - detect.py: get_stable_board_state() 추가 — 연속 두 번 같게 읽힐 때만
    결과를 채택한다. 손·팔이 지나가는 순간이나 조명이 흔들릴 때 엉뚱한
    배열을 그대로 쓰는 것을 막는다. 끝내 불안정하면 재시도를 요청.
    아두이노 재업로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
2026-08-05 문제 해결 기록 문서 추가 (TROUBLESHOOTING_LOG.md)
    이 프로젝트에서 실제로 막혔던 지점과 해결 방법을 8개 범주로 정리.
    설계안에 없었고 실물 제작 후에야 드러난 문제가 대부분이라 보고서·재현·
    인수인계에 쓸 수 있도록 원인과 대응을 함께 기록했다.
    기구학/좌표계, 하드웨어 손상 사고, 흡착 시스템, 카메라/비전,
    정확도 보정 접근법 변천(시뮬RL→실측→폐루프), 개발 환경, 재발 방지 장치,
    남은 과제.
    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
2026-08-05 정렬 중 흡착 유지 + 모든 이동 경로에 카메라 보정 적용
    1) align_over_square가 arm.move를 호출할 때 흡착 상태를 넘기지 않아,
    기물을 들고 place로 이동한 뒤 정렬하는 동안 흡착이 풀려 기물을
    떨어뜨렸다. suction 인자를 추가하고 호출부에서 명시적으로 전달.
    2) move 명령과 실전 게임(execute_move)에는 카메라 보정이 없었다.
    execute_move에 aligner 콜백을 추가해 하강 직전마다 호출하도록 하고,
    test_square의 move와 main.py --mode real 이 모두 이를 사용한다.
    기물을 든 구간(도착 칸 정렬)은 suction=True로 넘겨 흡착을 유지한다.
    이제 pick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
2026-08-05 문제 해결 기록을 비전문가도 읽을 수 있게 재작성 + 우선순위 부여
    - 시스템 동작 흐름을 먼저 설명해 처음 보는 사람도 문맥을 잡을 수 있게 함
    - 전체 문제를 ★★★/★★/★ 3단계로 등급화하고 SW/HW 분야를 표시한 요약표 추가
    - 각 문제를 '무슨 일이 있었나 → 왜 그랬나 → 어떻게 고쳤나' 3단 구성으로
    풀어 쓰고, 어려운 개념은 비유로 설명
    (예: 어깨 높이 = 자기 어깨가 책상 위에 있다고 착각한 것,
    펌프 전류 = 굵은 수도관 중간에 빨대를 끼운 것)
    - 정확도 보정은 세 번의 접근 변경(시뮬RL → 실측 → 카메라 폐루프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
2026-08-05 정렬: 비현실적으로 큰 측정 오차는 오인식으로 보고 무시
    마커 오인식(체스판·테이프·반사)으로 84mm 같은 값이 나오면 팔이
    엉뚱한 곳으로 크게 이동했다. ALIGN_MAX_ERR_CELLS(1.2칸≈35mm)를
    넘는 측정치는 믿지 않고 보정 없이 진행한다.
    Claude-Session: https://claude.ai/code/session_01LH4EnHTZqRnCXBSVhiNqwi
2026-08-05 test_square: 서보 각도 직접 이동 명령 'a' 추가
    한 관절만 바꿔 명령해서 그 모터가 실제로 도는지 격리 진단한다.
    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
2026-08-05 베이스 서보 교체: 정면 기준각 38도 -> 90도
    1번(베이스) 서보가 고장나 교체했다. 새 서보는 혼 결합 위치가 달라
    정면이 90도다. SERVO1_HOME 과 PARK_POSE 를 그에 맞춰 갱신하고,
    문서의 예시 각도와 배치 설명도 함께 고쳤다.
    도달 범위는 이전과 동일(46/64칸)하며, 실사용 s1은 70~142도로
    가동범위 양끝에서 충분히 떨어졌다.
    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
2026-08-05 관절 상한을 펌웨어와 일치(200)시키고, 실제 상한은 SERVO_SAFE_MAX로 관리
    - SERVO_MAX 180 -> 200 (servo_control.ino 의 ANGLE_HARD_MAX 와 동일)
    - SERVO_SAFE_MAX 는 180 유지. 개체별 실제 기계 한계를 확인한 뒤 올리도록
    확인 절차(SERVO_MAX_TEST_NOTE)를 코드에 남김
    - _rad_to_servo 가 SERVO_SAFE_MIN/MAX 까지 함께 검사한다. 이전에는 초과분을
    _clamp_safe 가 조용히 잘라내서 팔이 엉뚱한 곳에 있는데도 도착으로 여겼다
    - hardware/plan_board_pos.py 추가: 체스판을 어디에 놓아야 몇 칸에 닿는지
    테이프를 뜯기 전에 계산해 본다
    현재 배치(x=11cm)에서는 상한을 올려도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
2026-08-05 베이스 서보 정면각 실측값 85도로 수정 (90 -> 85)
    사용자가 직접 재본 결과 새 서보는 90도가 아니라 85도가 정면이었다.
    SERVO1_HOME, PARK_POSE 및 문서의 예시 각도를 실측값으로 갱신.
    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
    [arm_controller.py, test_square.py]
2026-08-05 test_square: 소프트 제한을 실행 중에 풀 수 있는 limit / probe 명령 추가
    한계를 재는 동안에는 소프트 제한이 방해가 됐다. 180도에서 잘려버려
    '여기가 진짜 기계 한계인지' 확인할 수 없었다.
    - limit: SERVO_SAFE_MIN/MAX 를 실행 중에 조회·변경 (그 실행에만 유효)
    - probe s3 180 200: 그 관절을 5도씩 올리며 매 단계 사람이 눈으로 확인.
    x 를 누르면 직전 값을 실제 한계로 잡고 되돌린 뒤, arm_controller.py 에
    적을 값을 알려준다
    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
2026-08-05 사람 수 인식을 '합법수 대조' 방식으로 교체하고, 최종 실행에 라이브 뷰 추가
    [문제] 실행 중 기물을 옮겨도 이동을 감지하지 못했다.
    기존 방식은 이전/현재 배치를 비교해 '사라진 칸 1개 + 나타난 칸 1개'를
    찾는 차분이었다. 칸 하나만 잘못 읽혀도 조건이 깨지고, 기물을 잡는 수는
    도착칸이 원래 차 있어 원리적으로 감지할 수 없었다.
    [해결] 규칙을 이미 안다는 점을 이용한다. 합법수(보통 20~40개)마다 그 수를
    뒀을 때의 배치를 만들어 화면과 대조하고 가장 잘 맞는 것을 고른다.
    1등이 2등보다 뚜렷하지 않으면 후보 5개를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
2026-08-05 기물 인식을 밝기 기반으로 교체 — 32개 기물을 전부 빈 칸으로 읽던 문제
    [원인] 기물 유무를 '셀 중앙의 밝기 분산'으로 판정하고 있었다. 발상이
    정반대였다. 기물이 셀 중앙을 덮으면 그 부분은 오히려 한 가지 색으로
    균일해져 분산이 0에 가까워진다. 빈 칸이 나뭇결 때문에 분산 5.6, 기물이
    덮은 칸은 분산 0.0 — 임계값 200으로는 셋 다 빈 칸이었다.
    [해결] 밝기로 판정한다. '그 칸이 비었을 때의 밝기'와 비교해 밝으면 흰,
    어두우면 검은, 비슷하면 빈 칸. 기준 밝기는 지금 비어 있어야 할 칸들에서
    매번 다시 잡으므로 조명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
2026-08-06 치명적 버그 수정: 카메라 보정이 하강 직전에 지워지던 문제 외 3건
    [1] 카메라 정렬 결과가 버려졌다 (가장 심각)
    정렬 함수가 팔을 보정 위치로 옮겨놓고 True/False 만 돌려줬는데, 이어지는
    하강 단계가 목표 칸 좌표로 IK 를 다시 계산했다. 즉 보정이 가장 중요한
    순간(하강·흡착) 직전에 통째로 사라졌다. 로그에는 '정렬 완료'가 찍히므로
    증상만으로는 알 수 없었다.
    → 정렬이 보정량(칸 단위)을 반환하고, 이후 모든 이동이 그 값을 얹는다.
    가짜 하드웨어 검증(팔이 +0.5/-0.3칸 어긋난다고 가정): 17.0mm → 3.4mm
    [2] 흡착 ON/OFF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
    [arm_controller.py, main.py, pick_marker.py, visual_align.py]
2026-08-06 정렬 허용 오차 4.4mm -> 2.0mm
    기물을 병뚜껑으로 바꾸면서 크기가 커지고 제각각이라 더 정밀한 정렬이 필요.
    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
2026-08-06 검은 기물이 어두운 칸에서만 안 보이던 문제 — 빈 판 기준 영상 방식 도입
    [증상] 판독이 한 칸 걸러 하나씩 비어 나왔다.
    8 b X b X b X b X
    7 X b X b X b X b
    격자 좌표로 확인하니 놓친 칸이 전부 같은 색(어두운 칸)이었다.
    [원인] 검은 기물과 어두운 칸은 둘 다 어둡다. 밝기 하나로는 구분할 수 없다.
    임계값을 낮추면 검은 기물이 잡히기 시작하지만 동시에 그림자도 기물로
    잡힌다(실제로 c3에 없는 기물이 나타났다). 맞바꿈이라 해결이 불가능하다.
    [해결] 기준을 '밝기'에서 '빈 판과 얼마나 달라졌는가'로 바꿨다.
    기물을 다 치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
2026-08-06 기물 윗면 색으로 판정하는 방식 추가 — 판 색깔과 무관하게 인식
    [문제] 병뚜껑도, 기존 작은 기물도 인식이 안 된다. 검은 기물 윗면이
    어두운 칸과 거의 같은 색이라 계속 격자무늬로만 읽힌다.
    [근본 원인] 카메라는 기물의 윗면만 본다. 그 윗면이 칸과 같은 색이면
    어떤 알고리즘으로도 구분할 수 없다. 검은 절연테이프를 붙인 것이
    오히려 문제를 굳혔다.
    [해결] 양쪽 기물 윗면에 체스판에 없는 진한 색을 붙이고 색으로 판정한다.
    PIECE_COLOR_MODE + PIECE_HSV_WHITE / PIECE_HSV_BLACK.
    합성 영상 실측 (기물 지름 12mm — 아주 작은 경우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
2026-08-06 자작 기물(23~26mm, 두께 4~5mm, 16개)에 맞게 조정
    측정·검증한 것:
    - 정사각 기물도 문제없다. 유령(이웃 칸 오검출)이 생기기 시작하는 치우침은
    23mm 13mm부터, 26mm 10mm부터. 실제 산포 +-7mm 이므로 둘 다 여유 있다.
    45도 돌려 놓아도 14mm까지 안전. 23mm 쪽이 여유가 더 크다.
    - 카페라떼+검정 판에서 파란색은 안전하다. 색상(H)이 판(H=18, H=0)과
    100 이상 떨어져 있다. 밝은 파랑/진한 남색 모두 64/64.
    - 흰색은 카페라떼 칸과 채도로만 갈리므로 경계에 있다.
    코드 변경:
    - PIECE_Z 7mm -> 4.5mm (기물이 얇아짐). 이전 값이면 흡착컵이 기물에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
2026-08-06 빈 판 기준 방식의 흑/백 판정을 색 기반으로 교체
    [증상] 점유 판정은 32/32 완벽한데(변화율 69~100%, 임계 18%) 흑/백만
    한 칸 걸러 뒤집혀 격자무늬가 됐다. 56/64.
    [원인] 흑/백을 '그 칸이 빈 칸일 때보다 밝은가'로 정하고 있었다.
    같은 색 기물이라도 어두운 칸에서는 밝게, 밝은 칸에서는 어둡게 보이므로
    판정이 칸 색을 그대로 따라간다. 파란 볼펜칠 기물에서 정확히 이 현상이 났다.
    [해결] 기물 색이 등록돼 있으면 그것으로 흑/백을 정한다. 점유 판정은
    검증된 빈 판 기준 방식을 그대로 쓰고, 편 구분만 색으로 한다.
    한쪽 색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
2026-08-06 흡착컵 마커 색을 노랑 -> 빨강(점퍼선)으로 변경
    노랑(H=20~38)이 카페라떼색 체스판 칸(H=18)과 색상이 거의 겹쳐 마커가
    안 잡혔다. 빨강은 H가 0 근처라 카페라떼(18)·검정 칸 모두와 떨어져 있다.
    빨강은 HSV에서 색상환 양끝(0쪽/179쪽)에 걸치므로 두 구간으로 등록했다.
    검은쪽 기물 색(파랑, HSV H=95~130)과는 겹치지 않음을 확인했다
    (pick_pieces.warn_marker_clash 로 검증).
    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
2026-08-06 RL 보정 기본 해제 + 정렬 오프셋을 삼키던 버그 수정, 라이브 뷰 기본 켜기
    [문제] RL 모델을 켜고 실행하니 e7e5 가 e파일 근처도 못 갔고 f8 을 한 칸
    빗나갔다.
    [원인 1] RL 행동 범위가 고칠 오차보다 7배 크다.
    학습 환경의 행동 범위 DELTA_LIMIT=±0.2rad(11.5도)인데 정작 학습에 쓴
    실제 오차 노이즈는 ±0.03rad(1.7도)뿐이다. 끝단 이동량으로 환산하면
    한 관절 0.2rad -> 3.4cm (1.2칸)
    세 관절 모두 -> 7.1cm (2.4칸)
    정책이 덜 수렴하면 큰 값을 내놓고 그대로 빗나간다.
    -> RL_MAX_DELTA=0.05rad 로 클램프 (잘리면 경고 출력)
    -> --rl 을 줬을 때만 켜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
    [main.py, test_square.py, visual_align.py]
2026-08-06 pick_pieces 가 색 방식을 켜지 못하던 버그 + 낡은 기준 영상 대응
    [버그] pick_pieces.py 가 PIECE_COLOR_MODE 를 True 로 못 바꿨다.
    정규식 "PIECE_COLOR_MODE = \w+" 가 count=1 로 치환되는데, 파일 위쪽
    설명 주석에 "PIECE_COLOR_MODE = True 로 켠다" 라는 문구가 먼저 있어서
    그 주석이 치환돼 버리고(내용 동일해 티가 안 남) 진짜 설정값은 False 로
    남았다. 그래서 색을 등록해도 계속 빈 판 기준 영상 방식으로 동작했다.
    -> 정규식을 줄머리(^)에 고정하고 re.M 추가
    [문제] 빈 판 기준 영상이 낡으면(판/카메라가 움직이거나 조명이 바뀌면)
    빈 칸에서도 '변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
2026-08-06 색 설정을 detect.py 에서 colors.json 으로 분리 — git pull 충돌 해소
    [문제] pick_pieces.py / pick_marker.py 가 vision/detect.py 를 직접 고쳤다.
    detect.py 는 git이 추적하는 파일이라, 색을 등록할 때마다 `git pull` 이
    "로컬 변경이 덮어써진다"며 실패했다. stash/pop 하다 충돌 마커가 남아
    detect.py 가 통째로 깨지기까지 했다(invalid syntax).
    [원인] 설계를 잘못했다. 색은 조명·카메라·기물마다 다른 값이라
    calibration.json 과 같은 성격인데, 소스 파일에 써넣게 만들었다.
    [해결] vision/colors.json (git 제외) 로 분리.
    - detect.py 는 기본값을 갖고, colors.json 이 있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
2026-08-06 '판정 방식' 표시가 실제와 달랐던 문제 수정
    색으로 판정하고 있는데도 화면에는 "판정 방식: 빈 판 기준 영상" 이라고
    떴다. 표시 코드가 self._ref 존재 여부만 보고, 색 등록 여부는 안 봤기
    때문이다. 아래쪽 상세 표에는 "기물 윗면 색으로 판정" 이라고 나와서
    같은 화면 안에서 서로 모순됐다.
    detection_mode() 를 추가해 get_board_state 의 분기와 같은 조건으로
    실제 쓰는 방식을 돌려주게 하고, check_board.py 와 main.py 가 그걸 쓴다.
    판독이 안 맞을 때의 안내도 고쳤다. 실제로는 인식이 아니라 --fen 이
    판 위 배치와 달라서인 경우가 많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
    [check_board.py, detect.py, main.py]
2026-08-06 markcal 결과도 colors.json 에 저장 (detect.py 수정 안내 제거)
    markcal 이 아직도 "영구 적용하려면 vision/detect.py 에 적으세요" 라고
    안내하고 있었다. 그렇게 하면 다시 git pull 이 충돌한다.
    이제 marker_offset 도 colors.json 에 넣고 저장 즉시 적용된다.
    오프셋이 반 칸을 넘으면 경고한다 (마커가 흡착컵에서 멀거나, 재는 순간
    흡착컵이 칸 중심에 안 맞춰져 있다는 뜻).
    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
    [detect.py, test_square.py]
2026-08-06 정렬을 '실제로 일할 높이'에서 하도록 변경 — 시차로 한 칸 어긋나던 문제
    [증상] 칸 위에서 정렬이 완료됐다고 뜨는데 하강하는 순간 한 칸 가까이
    어긋났다. 흡착컵이 e7 바로 위인데 화면에는 마커가 e8 에 찍히기도 했다.
    [원인] 시차(parallax). 카메라가 판을 정확히 수직으로 안 내려다보면
    판 위로 뜬 마커는 투영될 때 밀리고, 그 밀림은 높이에 비례한다.
    정렬은 안전높이 4.5cm 에서 하고 작업은 바닥 0.15cm 에서 하니, 높은 데서
    '맞다'고 판단한 위치가 낮은 데서는 틀린 위치였다.
    정렬 높이 4.5cm -> 흡착컵 오차 19.0mm (0.65칸)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
2026-08-06 정렬 측정 높이 6.5mm -> 8mm
    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
2026-08-06 정렬 측정 높이 8mm -> 15mm (8mm에서 흡착컵이 기물을 밀어내고 판에 닿음)
    측정 높이를 올리면서 이동 높이(ALIGN_CLEAR_LIFT)도 12mm -> 20mm 로 같이
    올렸다. 그대로 두면 이동 높이가 측정 높이보다 낮아져, 옆으로 옮기는
    동안 오히려 기물에 부딪힌다.
    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
2026-08-06 정렬 측정 높이 18mm + 마커 오버레이를 실제 위치에 그리도록 수정
    [높이] 15mm -> 18mm (ALIGN_WORK_LIFT). 이동 높이도 23mm 로 같이 올렸다.
    [표시] 마커 원을 '반올림한 칸의 중앙'에 그리고 있었다. 그래서 마커가
    칸 구석에 잡혀도 화면에는 중앙에 있는 것처럼 보였다. 인식 자체는 처음부터
    소수점 좌표를 썼지만, 화면만 보고는 알 수 없어 오해를 부른다.
    이제 검출된 실제 픽셀 위치에 원+십자를 그리고, 잡힌 덩어리 윤곽도 표시하며,
    좌표를 소수점까지 보여준다 (예: MARK e7 (4.24,6.22)).
    합성 영상 검증: 칸 구석(64,163)에 그린 마커를 (6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
    [detect.py, visual_align.py]
2026-08-06 측정 높이 25mm + 시차 보정을 여러 점 어파인으로 (markcal add/fit)
    [높이] ALIGN_WORK_LIFT 18 -> 25mm, ALIGN_CLEAR_LIFT 23 -> 30mm.
    [문제] 정렬이 맞추는 것은 '마커'다. 카메라가 완전한 수직이 아니면 마커는
    시차로 밀려 보이므로, 마커를 칸 중심에 맞추면 흡착컵은 반대편으로 밀린다.
    허용오차 2mm 는 마커 기준이라 '완료'가 떠도 흡착컵은 10mm 벗어나 있다.
    사용자가 본 "칸 중심에서 떨어져 있어도 중앙으로 판단한다"가 이 현상이다.
    측정 높이 25mm 기준 밀림: 판 중심에서 5cm 3.3mm / 10cm 6.7mm / 15cm 10.0mm.
    [해결] 밀림이 위치에 비례하므로 상수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
2026-08-06 markcal auto 추가 — 팔이 스스로 20칸을 돌며 시차를 잰다
    [문제] 앞서 안내한 markcal 절차가 "흡착컵을 칸 중심에 손으로 맞추라"는
    것이었는데, 팔/판/카메라가 전부 고정돼 있어 실제로 할 방법이 없었다.
    [해결] markcal auto: 팔이 20칸(a/c/f/h 파일 x 랭크4~8)을 돌며 각 칸에서
    마커를 잰다. '명령한 칸 = 실제 흡착컵 위치'로 놓고 최소제곱한다.
    근거: 없애려는 시차는 위치에 비례하는 계통 오차이고, 관절 유격은 매번
    방향이 달라지는 무작위 오차다. 여러 점을 최소제곱하면 무작위는 상쇄되고
    계통 성분만 남는다. 팔이 부정확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
2026-08-06 전체 코드 비판적 검토 — 실제 결함 5건 수정
    [1] 캐슬링/앙파상/승진에서 엔진과 실제 판이 어긋남 (치명적)
    execute_move 가 '한 수 = 기물 하나를 from->to' 라고 가정했다. 규칙상 한
    수라도 물리적으로는 동작이 여러 개인 경우가 있다.
    캐슬링: 킹만 옮기고 룩이 그대로 남음
    앙파상: 도착 칸(빈 칸)을 치우려 하고, 정작 잡힐 폰은 남음
    승진 : 판엔 폰인데 엔진은 퀸으로 앎
    -> utils.chess_utils.physical_ops 로 수를 물리 동작 목록으로 분해하고
    execute_move 가 그 목록을 실행하도록 재구성했다(_clear_square/_pick_place).
    승진은 로봇이 못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
    [arm_controller.py, calibrate.py, calibrate_board.py, detect.py, live_view.py]
2026-08-07 팔이 판을 파고들던 문제 + 가장자리에서 마커가 안 보이던 문제
    [1] 램프가 관절별로 따로 끝나 경로가 판을 파고들었다 (치명적)
    _ramp_send 가 관절마다 똑같이 2도씩 움직이다가 각자 목표에 닿으면 멈췄다.
    적게 도는 관절이 먼저 끝나고 남은 관절이 마저 도는 동안 팔이 엉뚱한 자세를
    지나간다. markcal auto 처럼 낮은 높이로 칸 사이를 이동할 때 흡착컵이
    체스판 아래로 최대 62mm 파고들었다(모의 계산).
    a8->c4 -16.1mm / c8->f4 -33.5mm / f8->h4 -62.6mm
    -> 세 관절이 같이 출발해 같이 도착하도록 비율을 맞췄다(관절공간 직선).
    같은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
2026-08-07 vision: 로봇팔 배치를 카메라 기준 오른쪽으로 변경
    설치 장소가 바뀌어 탑뷰에서 로봇팔이 오른쪽 변에 오게 되었다.
    ROBOT_SIDE = "right" 로 바꾸면 chess_to_grid / chess_to_grid_inv /
    grid_uv_to_colrow 세 함수와 디버그 오버레이가 모두 따라간다.
    네 방향 모두 전단사·역변환·연속좌표 일치를 확인했고, right 배치에서
    랭크8(로봇쪽)이 화면 오른쪽, 파일 a→h 가 화면 위→아래로 가는 것을 확인했다.
    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
2026-08-07 vision: 흰 기물이 카페라떼색 칸에 묻히는 문제 — 적응 범위 + 감마
    원인은 색이 아니라 **범위를 넓히는 폭**이었다. 흰 기물과 카페라떼 칸은
    색상(H)이 거의 같고(둘 다 H≈18) 채도만 다른데(5 vs 83), pick_pieces 가
    표본 범위를 무조건 S±70 으로 넓혀서 흰 기물 범위가 S 0~86 이 되어 판을
    덮어버렸다. 합성 검증: 판 픽셀 219/800 오검출.
    - pick_pieces: 음성 표본(판 색)을 모으고, 음성이 하나도 안 들어가는
    가장 큰 상자를 축별로 탐색한다. 여유 있는 축(H,V)은 ±70 그대로,
    여유 없는 축(흰 기물 S)은 ±30 까지만 넓힌다.
    같은 합성 조건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
2026-08-07 vision: 빈 칸이 흰 기물로 읽히는 원인을 화면에 직접 찍어준다
    사용자 출력(48/64, 밝은 칸이 전부 100% 흰쪽)을 합성 보드로 재현했다.
    등록된 흰쪽 범위가 (8,0,170)~(28,86,255) 인데 카페라떼 칸이 (19,83,222)
    라서 범위 안에 그대로 들어간다. 표만 봐서는 이걸 알 수 없었다.
    - explain_board_state: 등록된 범위와 **지금 화면의 빈 칸 색**을 나란히 찍고
    범위 안이면 ❌ 로 표시한다. 재현 시 "밝은 칸 HSV=(19,83,222) ❌ 흰쪽
    기물 범위 안!" 이 나오고, 새 적응 범위로 다시 등록하면 64/64.
    - check_board: explain 에 expect 를 넘긴다(빈 칸만 표본으로 삼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
2026-08-07 vision: 자동 화이트밸런스가 밝은 칸을 흰색으로 만드는 문제
    --watch 는 64/64 인데 한 장만 읽으면 48/64 였다. AE/AWB 가 수렴하는 데
    몇 초 걸려서, 라이브 뷰는 수렴 후를, 방금 연 프로그램은 수렴 전을 본다.
    감마 3.0 출력(밝은 칸 HSV=(50,9,226))을 역산하니 센서 원본이 V≈245 S≈3
    이었다. 나무색이면 S≈83 이어야 한다. 즉 밝은 칸이 무채색 흰색으로 찍히고
    있었고, 이러면 흰 기물과 원리상 구분이 안 된다. AWB 가 화면 평균을
    무채색으로 맞추려는데 판이 대부분 베이지색이라 그 색조를 상쇄한 것이다.
    감마로는 못 고친다 — 0에 뭘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
2026-08-07 pick_pieces: 색깔별 개수 대신 실제 판정 결과를 보여준다
    `cells white=17 black=16` 은 색깔별로 따로 센 숫자라 겹치는 칸이 두 번
    잡힌다. 기물 옆면이 흰 종이면 파란 기물 테두리가 흰쪽으로도 잡혀 17이
    되는데, 실제 판정은 '비율이 큰 쪽이 이긴다'라서 그 칸은 검은쪽으로
    제대로 간다. 즉 17은 문제가 아닌데 문제처럼 보였다.
    - VERDICT (실제 판정 규칙을 그대로 적용한 white/black/empty) 를 같이 표시
    - ambiguous — 두 색 비율이 2배 안쪽이라 조명이 흔들리면 뒤집힐 수 있는
    칸 수. 이게 0인지가 진짜 안전 기준이다.
    - 16/16/32 이고 ambiguous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
2026-08-07 pick_pieces: ambiguous 를 0일 때도 항상 표시
    값이 0이면 항목 자체를 숨기고 있었다. 그래놓고 "0인지 확인하라"고 했으니
    성립하지 않는 안내였다 — 안 보이는 것과 0인 것을 구분할 수 없다.
    VERDICT / ambiguous / board leak 을 항상 찍고, 세 조건이 다 만족될 때만
    초록으로 칠한다. 두 줄로 나눠 창 폭(550px) 안에 들어가는 것을 확인했다.
    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
    [pick_pieces.py]
2026-08-07 vision: 랭크8에서 마커를 놓치는 문제 — 자세별 밝기 변화를 담는다
    pick_marker 가 한 자세에서 클릭한 표본을 무조건 H±8 S±60 V±60 으로 넓혔다.
    팔이 로봇 쪽(랭크8)으로 접히면 마커가 그늘에 들어가 어두워지는데, 밝을 때
    잡은 V 하한 아래로 떨어져 못 잡는다. 감마를 올리면 더 심해진다.
    그늘을 곱셈 모델(채도 유지, 밝기만 감소)로 두고 합성 검증:
    밝은 자세만 클릭 — 예전 방식: 그늘 64.8%, 짙은 그늘 0.0%
    지금 방식: 그늘 100%, 짙은 그늘 99.5%
    - 음성 표본(판)을 모아 넓힐 폭을 정한다. 축별 상한을 둔다:
    H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
2026-08-07 vision: 외곽 칸에서 마커가 '화면에 아예 없는' 경우를 진단한다
    색이 안 맞아 못 찾는 것과, 마커가 카메라 화각 밖이라 화소 자체가 없는
    것은 고치는 방법이 완전히 다른데 "MARK: not found" 로는 구분이 안 됐다.
    - margin_report(): 판 바깥을 카메라가 몇 칸까지 보는지 변마다 잰다.
    ⚠️ '검은 픽셀 비율'로 재면 판 주위 책상이 어두울 때 오판한다.
    탑뷰 좌표를 역변환해 원본 화면 안인지 기하로 따진다.
    검증: 판이 화면에 꽉 찬 경우 사방 0.1칸(❌), 한 변만 잘린 경우 그
    변만 0.0칸(❌), 여유 있는 경우 3.3~3.5칸(✅) — 책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
2026-08-07 markcal fit: 어느 칸이 나쁜지 알려주고, 팔 오차와 시차를 구분해준다
    평균·최대 잔차만 찍어서 '랭크 7~8 에서만 틀어진다'는 것을 알 수 없었다.
    - 잔차가 큰 칸 5개를 이름과 함께 표시
    - 랭크 7~8 평균 vs 랭크 1~6 평균을 나란히 비교. 로봇 쪽만 크게 나쁘면
    시차가 아니라 팔 자체의 계통 오차라고 알리고 calibrate_board 로 안내.
    markcal 이 팔의 계통 오차를 못 고친다는 것을 수치로 확인했다.
    markcal 은 marker→명령칸 을 학습하는데, 그때 팔은 이미 명령칸에서
    벗어나 있다. 정렬 루프는 '마커가 맞게 보이는 곳'으로 수렴하므로 그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
2026-08-07 hardware: 정렬 허용오차 0.5mm, 눌러내림 8mm 로 변경
    ALIGN_TOL_CELLS 0.0687→0.0172 (2.0mm→0.5mm)
    TOUCH_PRESS 0.003→0.008 (3mm→8mm)
    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
2026-08-07 hardware: 정렬 허용오차 1mm, 눌러내림 5mm 로 변경
    ALIGN_TOL_CELLS 0.0172→0.0343 (0.5mm→1.0mm)
    TOUCH_PRESS 0.008→0.005 (8mm→5mm)
    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
2026-08-07 hardware: 눌러내림 8mm 로 변경
    TOUCH_PRESS 0.005→0.008 (5mm→8mm)
    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
2026-08-07 hardware: 눌러내림 13mm 로 변경
    TOUCH_PRESS 0.008→0.013 (8mm→13mm)
    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
2026-08-07 정렬: 기물의 실제 중심을 목표로 삼고, 최선의 위치로 내려간다
    ① 기물을 카메라로 보고 그 중심에 맞춘다
    정렬은 흡착컵을 '칸 중심'에 맞췄다. 그런데 사람이 둔 기물은 칸 중심에서
    몇 mm 씩 치우쳐 있다. 기물 23~26mm vs 칸 29mm 라 5mm 만 어긋나도
    흡착컵이 기물 끝을 문다.
    - detect.piece_center(col,row): 그 칸 기물 덩어리의 무게중심을 연속 칸
    좌표로 반환. 기물은 높이 4~5mm 라 시차가 없어 그대로 쓸 수 있다.
    칸 중심에서 0.40칸 넘게 벗어나면 옆 칸 기물로 보고 버린다.
    - align_over_square(target=...) 로 목표를 바꿀 수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
2026-08-07 정렬: 기물 위치를 팔이 움직이기 전에 미리 찍어둔다
    지적받은 대로, 기물 중심을 정렬 직전에 재던 것이 틀렸다. 그 시점엔 팔이
    이미 그 칸 위 안전높이에 있어서 카메라가 기물을 못 본다 — 흡착컵의
    무게중심을 기물 중심이라고 하게 된다.
    e2 기물의 실제 치우침 (파일,랭크) = (+1.3, -2.9)mm
    팔이 가린 채 즉석 측정 : (-5.2, -5.2)mm ← 흡착컵을 잡음
    미리 찍어둔 값 : (+1.2, -3.5)mm ← 정확
    - snapshot_pieces(): 판 전체 64칸의 기물 중심을 한 번에 기록.
    팔이 park 에 있어 판이 통째로 보이는 시점에 부른다.
    · main.py — e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
2026-08-07 수를 둔 뒤 카메라로 확인해 재시도하고, 하강 밀림을 학습한다
    ① 확인 후 재시도 (hardware/verify_move.py)
    흡착이 빗나가면 팔은 그걸 모르고 빈 흡착컵을 목표 칸에 내리고 끝낸다.
    그러면 엔진이 아는 판과 실제 판이 어긋난 채로 게임이 계속됐다.
    → 팔을 park(Z자)로 접어 시야를 비운 뒤 실제 판을 읽고 판정한다:
    ok 기대대로 됨
    retry 아무 일도 안 일어남(출발 칸 그대로) → 최대 2회 자동 재시도
    manual 어중간하게 틀어짐 → 사람에게 넘기고 Enter 대기
    ⚠️ 재시도할 때마다 기물 위치를 다시 찍는다(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
